SASU-Robotac/Robotac_Share/README.md

# Robotac_Share
Share docs and drawing for robotac
