SASU-Robotac/Robotac_Share/自动机器人/自动机器人基础版程序/ReadMe.txt

1、【Code_ForRobotac_ZDC_v2019_BaseType】 控制器基础程序。
2、控制器基础程序说明文档；
3、自动机器人控制器说明文档；
