SASU-Robotac/Robotac_Share/基础底盘/基础底盘开源机械图/基础车.SLDASM

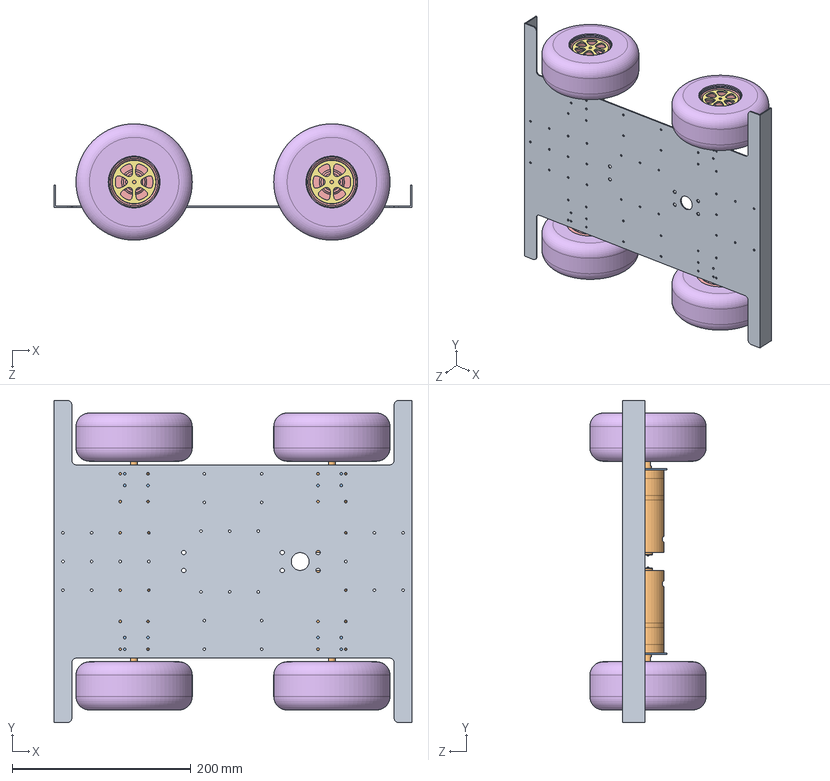
[picture p85: CAD file, 2020-01-18]
基础底盘/基础底盘开源机械图/基础车.SLDASM
400.2 x 360.0 x 129.9 mm
基础车钣金
电机YG36-555 x 4
电机座 x 4
六角联轴器 x 4
轮毂 x 4
胎皮 x 4
轮毂片 x 4
