SASU-Robotac/Robotac_Share/基础底盘/基础底盘开源机械图/轮系.SLDASM

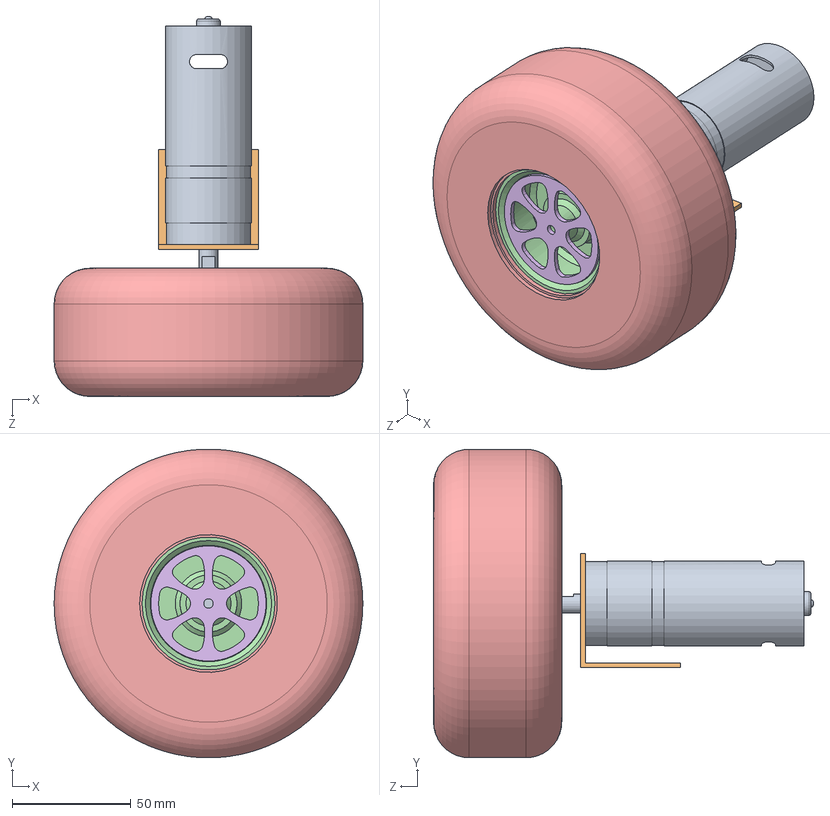
[picture p86: CAD file, 2020-01-18]
基础底盘/基础底盘开源机械图/轮系.SLDASM
130.0 x 129.9 x 160.0 mm
电机YG36-555
电机座
六角联轴器
轮毂
胎皮
轮毂片
