SASU-Robotac/Robotac_Share/气铲攻击机器人/气铲攻击机器人轮式配体/QC-气缸.SLDASM

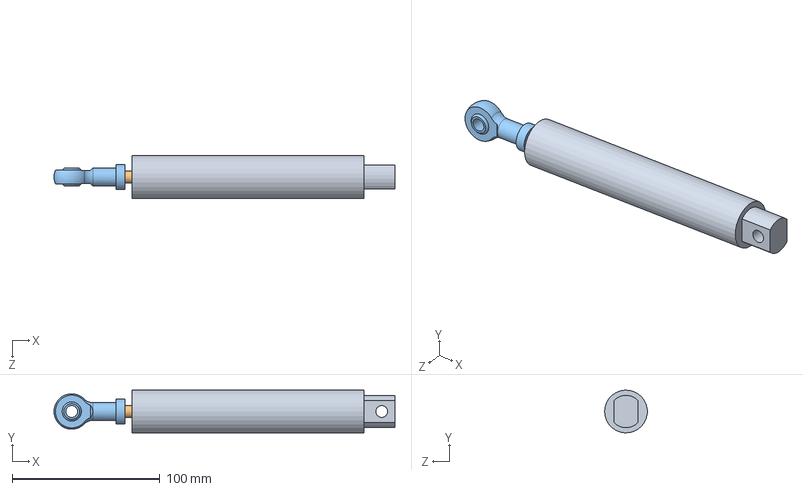
[picture p88: CAD file, 2020-02-25]
气铲攻击机器人/气铲攻击机器人轮式配体/QC-气缸.SLDASM
231.0 x 29.0 x 29.0 mm
QC-气缸壁
QC-气缸芯
QC-杆端轴承
