SASU-Robotac/Robotac_Share/气铲攻击机器人/气铲攻击机器人轮式配体/气铲总装配体.SLDASM

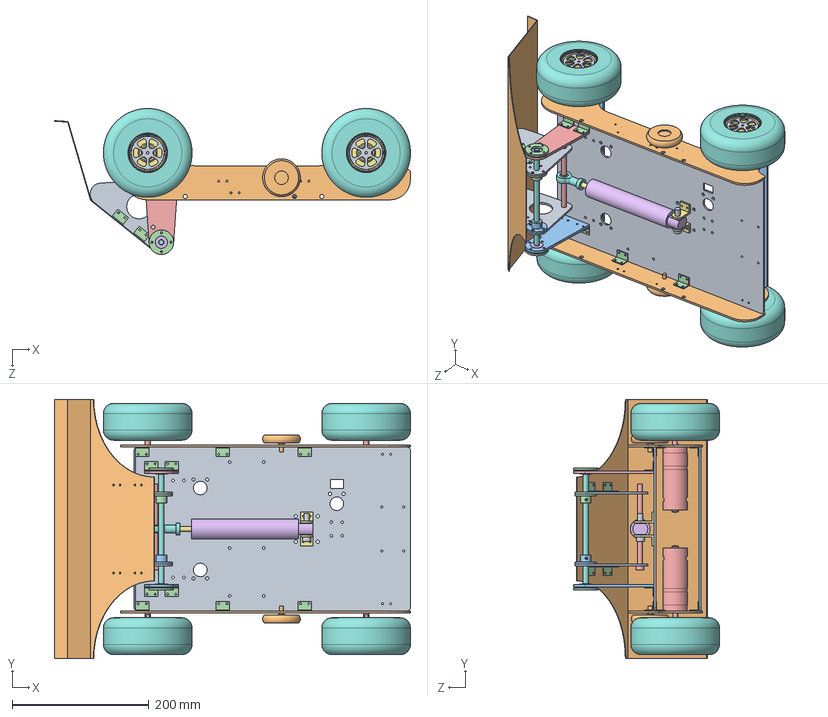
[picture p89: CAD file, 2020-02-25]
气铲攻击机器人/气铲攻击机器人轮式配体/气铲总装配体.SLDASM
521.6 x 380.0 x 214.0 mm
QC-底板
QC-侧板 x 2
QC-下板 x 2
直角连接件 x 20
电机YG36-555 x 4
六角联轴器 x 4
轮毂 x 4
胎皮 x 4
轮毂片 x 4
辅助轮 x 2
QC-轴支撑板
QC-轴承压片 x 2
M8x120螺栓
6mm轴承 x 2
直角支架 x 2
气铲横轴
QC-铲支撑板 x 2
铲
法兰联轴器-孔8
镜向法兰联轴器-孔8
镜向QC-轴支撑板
QC-气缸壁
QC-气缸芯
QC-杆端轴承
M8x35螺栓
