SASU-Robotac/Robotac_Share/电铲攻击机器人/电铲攻击机器人轮式装配体/电铲轮式装配体1.SLDASM

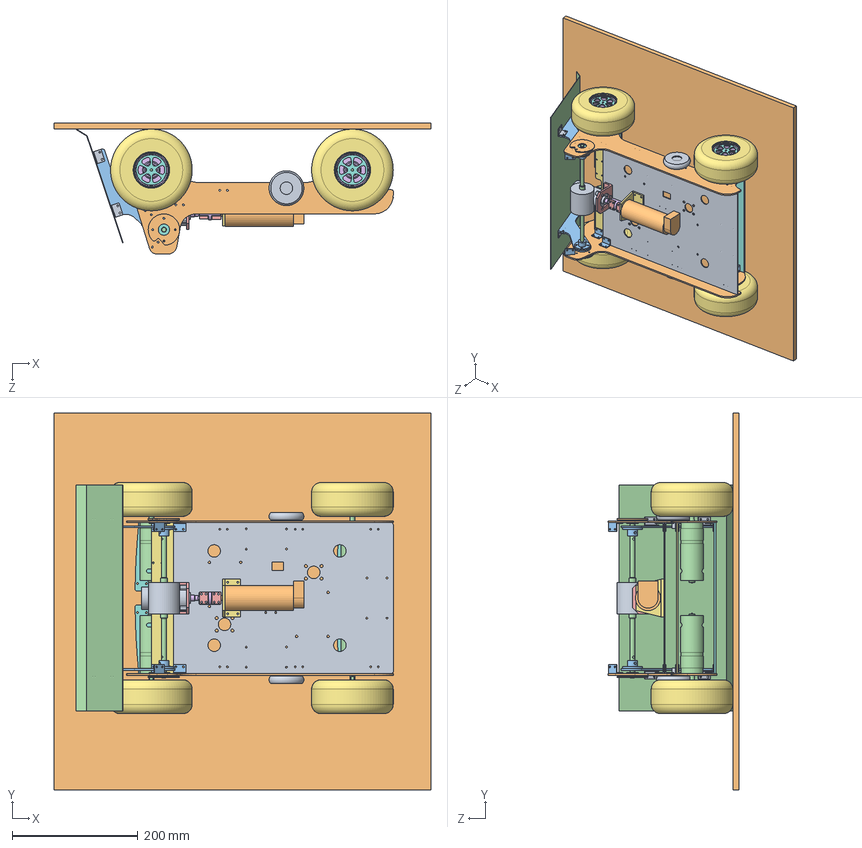
[picture p90: CAD file, 2020-02-17]
电铲攻击机器人/电铲攻击机器人轮式装配体/电铲轮式装配体1.SLDASM
600.0 x 600.0 x 209.0 mm
底板
侧板 x 2
直角连接件 x 18
电机YG36-555 x 4
六角联轴器 x 4
轮毂 x 4
胎皮 x 4
轮毂片 x 4
DC-换向器
DC-RE40
DC-法兰盘x2 x 2
DC-横轴x2 x 2
DC-换向器座
DC-纵轴
DC-电机座
DC-轴承 x 2
TY-直角连接件 x 4
轴承挡片 x 2
大臂 x 2
铲子
压片 x 2
压片联轴器
支撑板一
支撑板二 x 2
辅助轮 x 2
