SASU-Robotac/Robotac_Share/自动机器人/自动机器人装配体/轮系.SLDASM

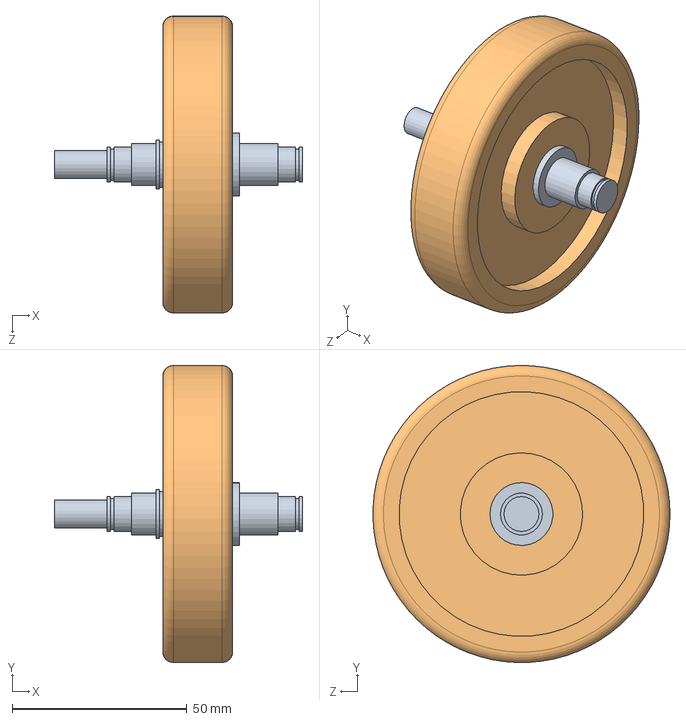
[picture p91: CAD file, 2020-03-14]
自动机器人/自动机器人装配体/轮系.SLDASM
71.0 x 85.0 x 85.0 mm
轮轴
轮子
