SASU-Robotac/Robotac_Share/电铲攻击机器人/电铲攻击机器人轮式装配体/轮系.SLDASM

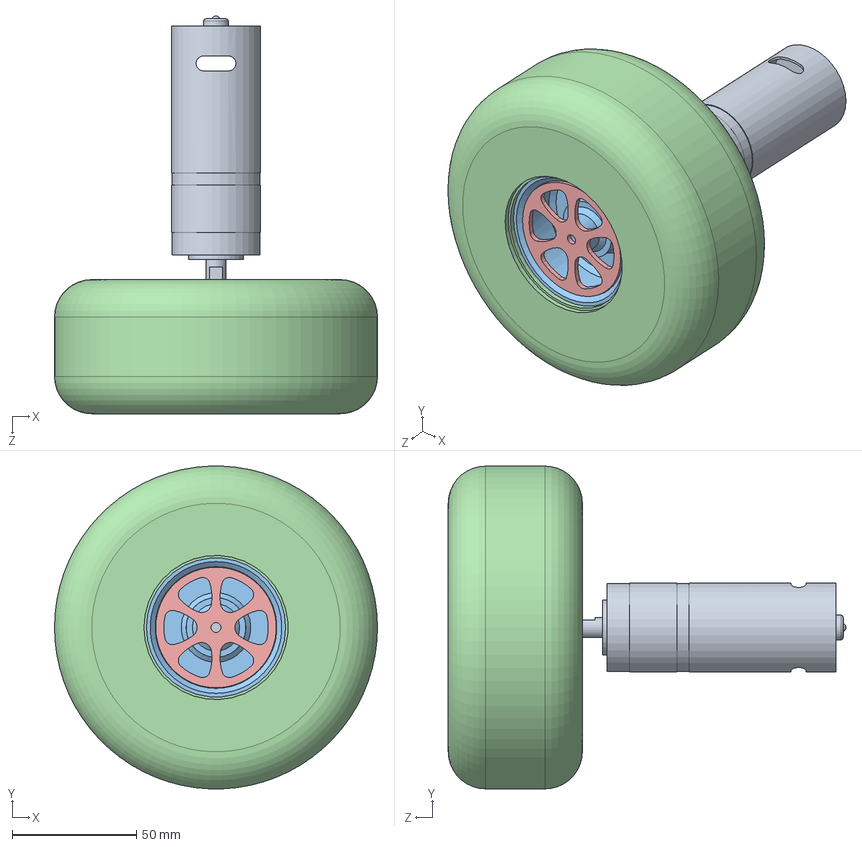
[picture p92: CAD file, 2020-02-17]
电铲攻击机器人/电铲攻击机器人轮式装配体/轮系.SLDASM
130.0 x 129.9 x 160.0 mm
电机YG36-555
六角联轴器
轮毂
胎皮
轮毂片
