SASU-Robotac/Robotac_Share/气铲攻击机器人/气铲攻击机器人轮式配体/气铲机构.SLDASM

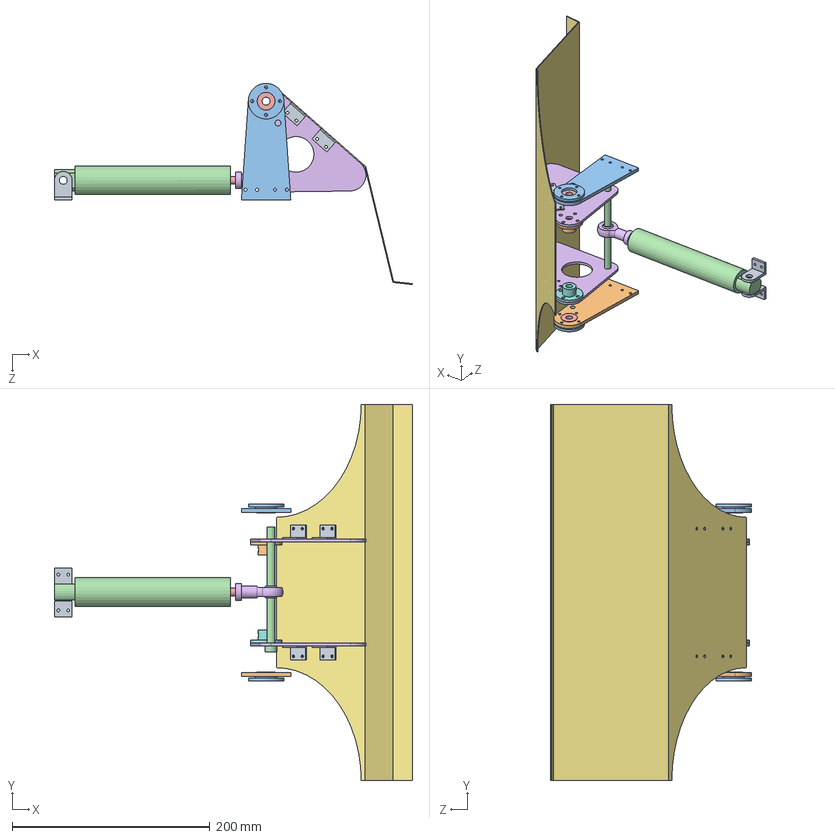
[picture p93: CAD file, 2020-02-25]
气铲攻击机器人/气铲攻击机器人轮式配体/气铲机构.SLDASM
362.0 x 380.0 x 203.4 mm
QC-轴支撑板
QC-轴承压片 x 2
M8x120螺栓
6mm轴承 x 2
直角支架 x 2
QC-铲支撑板 x 2
铲
法兰联轴器-孔8
直角连接件 x 4
镜向法兰联轴器-孔8
镜向QC-轴支撑板
QC-气缸壁
QC-气缸芯
QC-杆端轴承
