SASU-Robotac/Robotac_Share/电铲攻击机器人/电铲攻击机器人轮式装配体/DC-机构.SLDASM

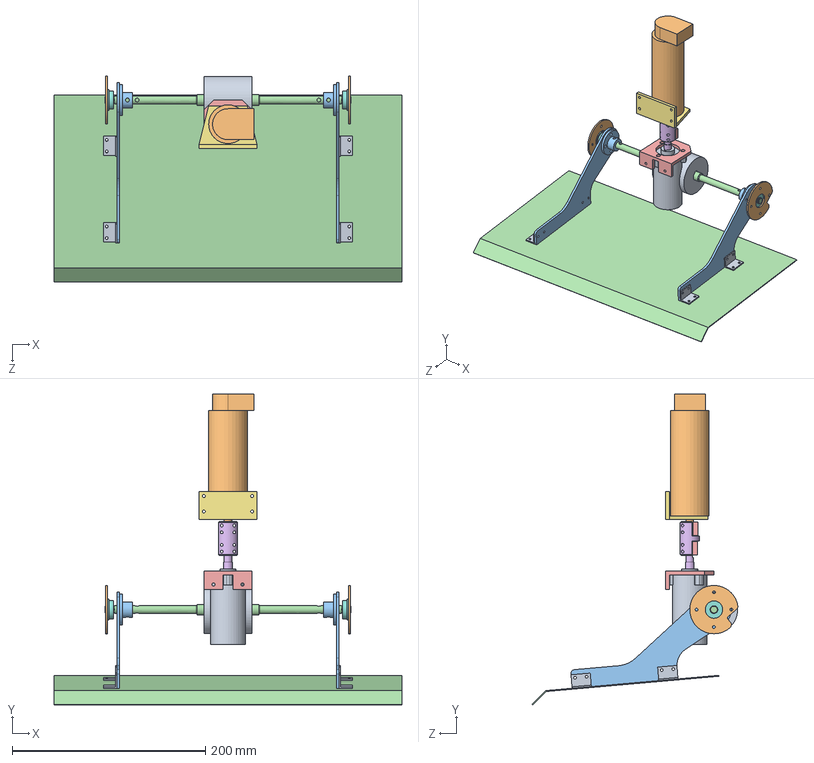
[picture p94: CAD file, 2020-02-17]
电铲攻击机器人/电铲攻击机器人轮式装配体/DC-机构.SLDASM
360.0 x 321.6 x 212.8 mm
DC-换向器
DC-RE40
DC-法兰盘x2 x 2
DC-横轴x2 x 2
DC-换向器座
DC-纵轴
DC-电机座
DC-轴承 x 2
TY-直角连接件 x 4
轴承挡片 x 2
大臂 x 2
铲子
压片 x 2
压片联轴器
