SASU-Robotac/Robotac_Share/自动机器人/自动机器人装配体/电机装配.SLDASM

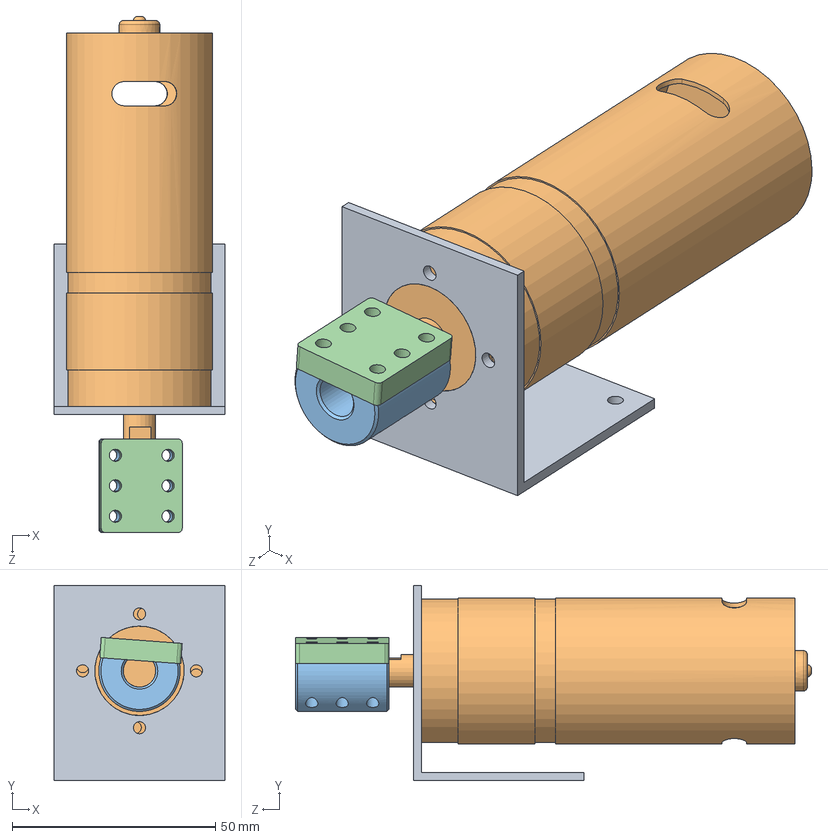
[picture p95: CAD file, 2020-03-14]
自动机器人/自动机器人装配体/电机装配.SLDASM
42.0 x 48.0 x 127.0 mm
电机座
电机YG36-555
压片联轴器
压片
