SASU-Robotac/Robotac_Share/自动机器人/自动机器人装配体/底盘装配体.SLDASM

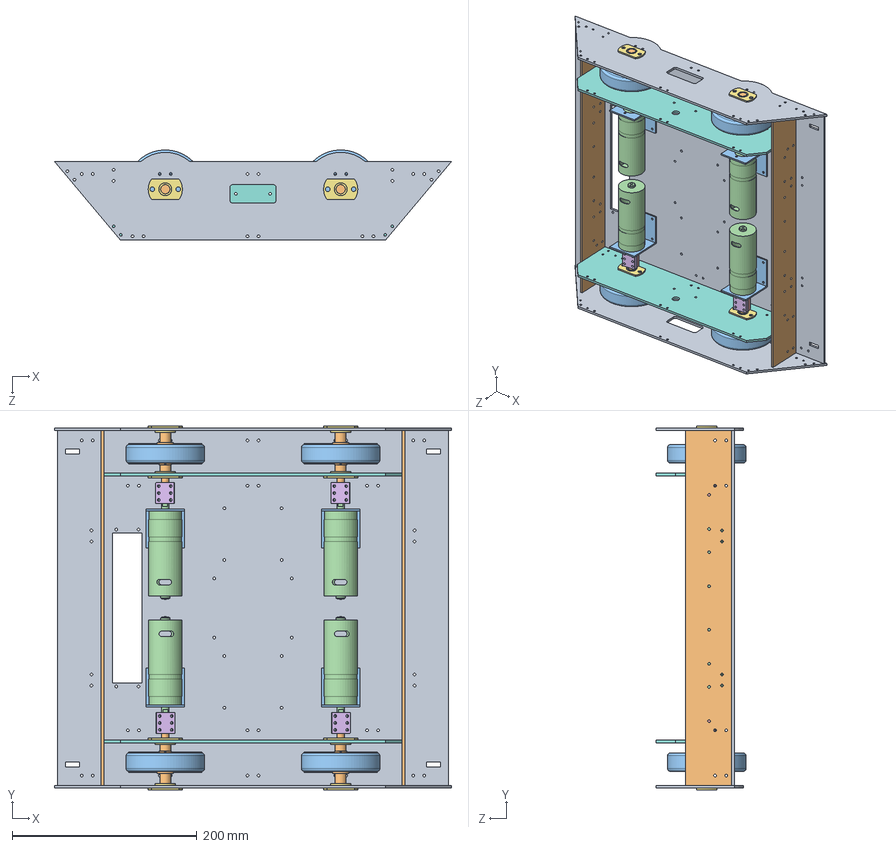
[picture p96: CAD file, 2020-03-14]
自动机器人/自动机器人装配体/底盘装配体.SLDASM
430.0 x 394.0 x 97.5 mm
侧面基板 x 2
红外安装板 x 2
电机座 x 4
电机YG36-555 x 4
压片联轴器 x 4
压片 x 4
轴承座 x 8
内侧轴承板 x 2
底盘基板
轮轴 x 4
轮子 x 4
