SASU-Robotac/Robotac_Share/气铲攻击机器人/气铲攻击机器人轮式配体/QC-杆端轴承.SLDPRT

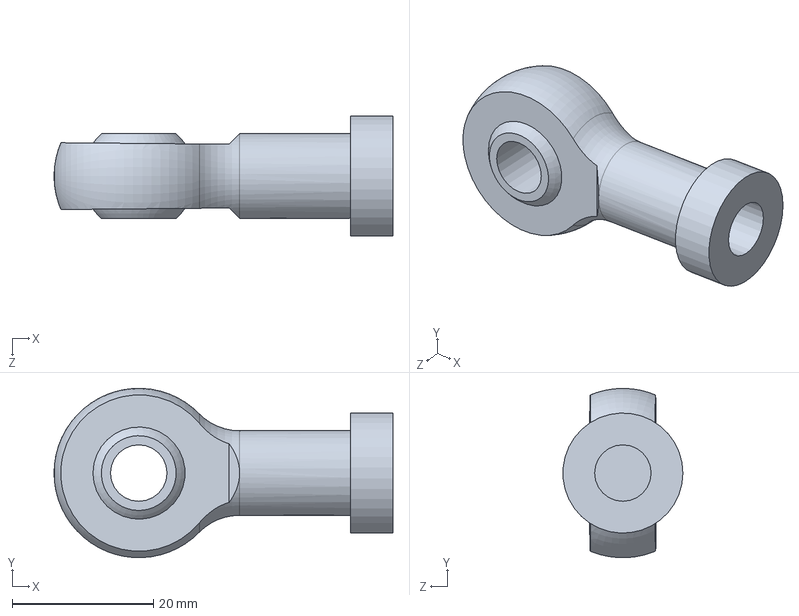
[picture p97: CAD file, 2020-02-25]
气铲攻击机器人/气铲攻击机器人轮式配体/QC-杆端轴承.SLDPRT
48.0 x 24.0 x 17.0 mm
