SASU-Robotac/Robotac_Share/电铲攻击机器人/电铲攻击机器人轮式装配体/支撑板一.SLDPRT

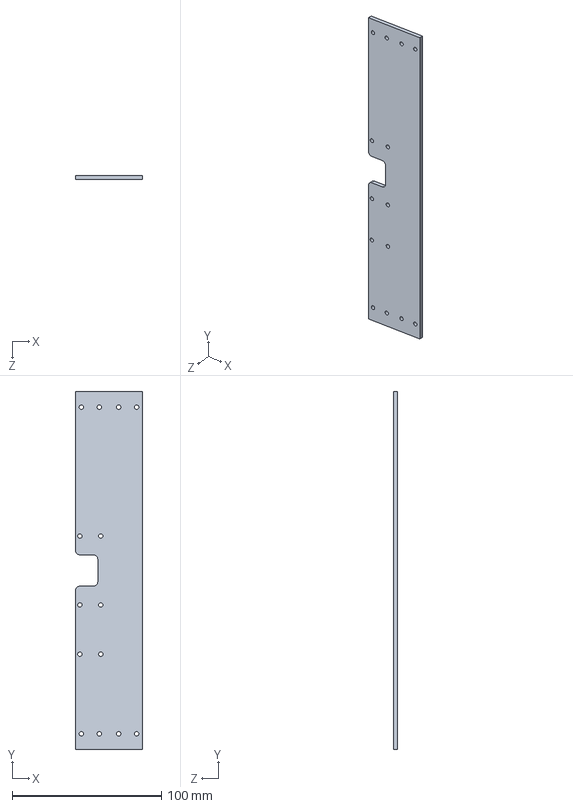
[picture p98: CAD file, 2020-02-17]
电铲攻击机器人/电铲攻击机器人轮式装配体/支撑板一.SLDPRT
45.0 x 240.0 x 3.00 mm
