SASU-Robotac/Robotac_Share/自动机器人/自动机器人装配体/轴承座.SLDPRT

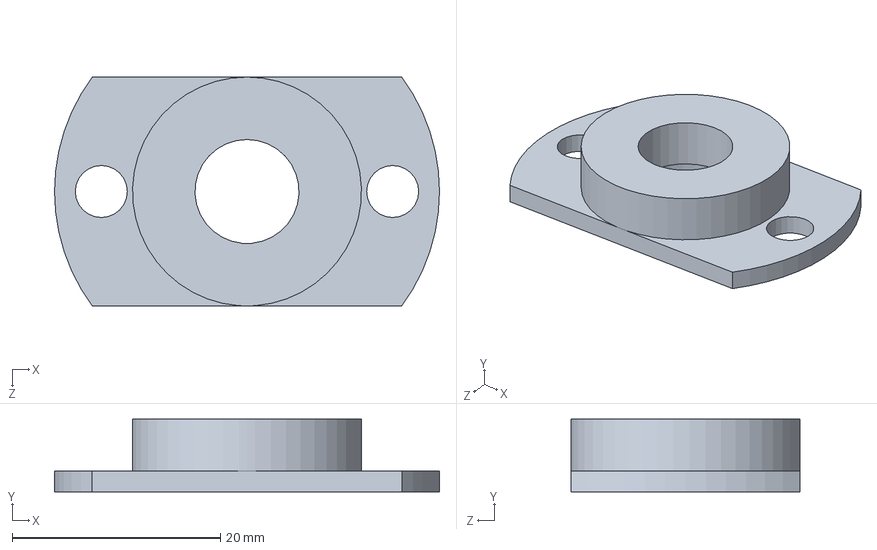
[picture p99: CAD file, 2020-03-14]
自动机器人/自动机器人装配体/轴承座.SLDPRT
37.0 x 7.00 x 22.0 mm
