SASU-Robotac/Robotac_Share/基础底盘/基础底盘开源机械图/电机座.SLDPRT

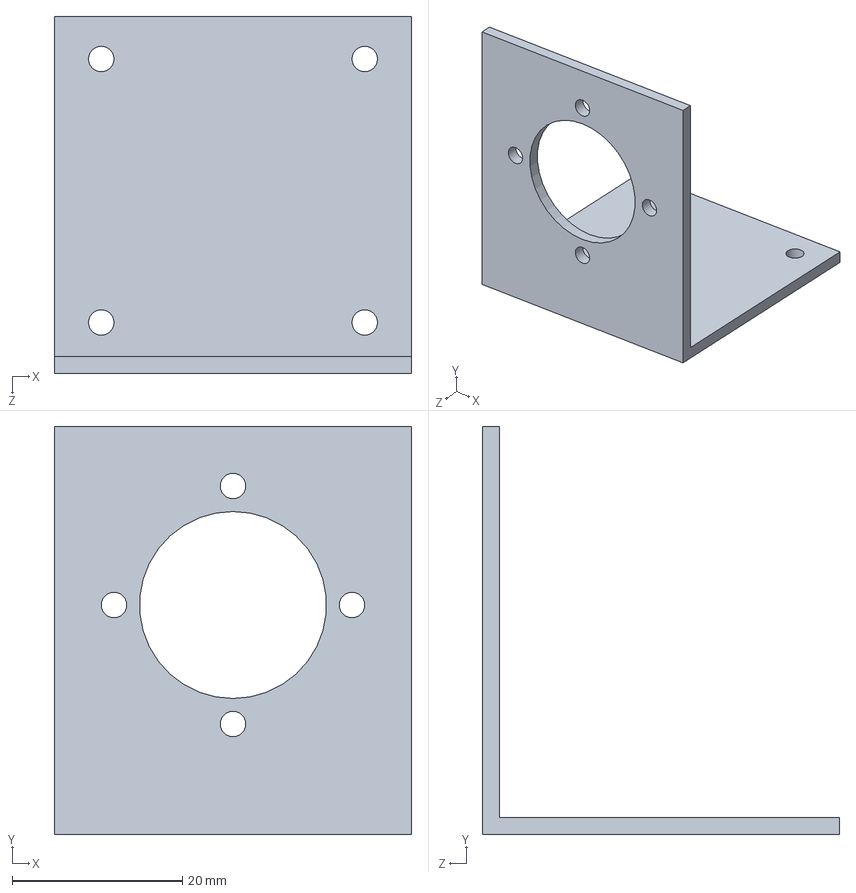
[picture p100: CAD file, 2020-01-18]
基础底盘/基础底盘开源机械图/电机座.SLDPRT
42.0 x 48.0 x 42.0 mm
