SASU-Robotac/Robotac_Share/气铲攻击机器人/气铲攻击机器人轮式配体/6mm轴承.SLDPRT

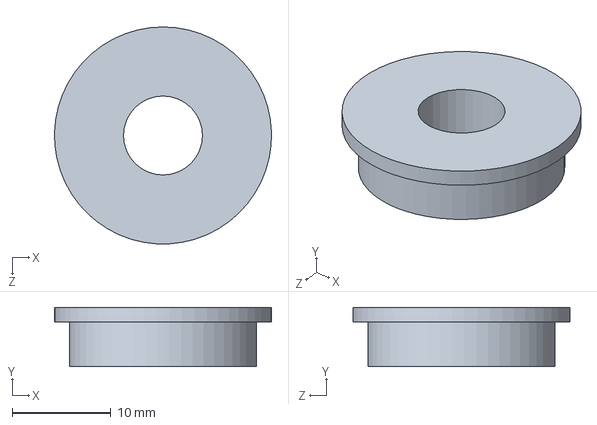
[picture p101: CAD file, 2020-02-25]
气铲攻击机器人/气铲攻击机器人轮式配体/6mm轴承.SLDPRT
22.0 x 6.00 x 22.0 mm
