SASU-Robotac/Robotac_Share/电铲攻击机器人/电铲攻击机器人轮式装配体/压片.SLDPRT

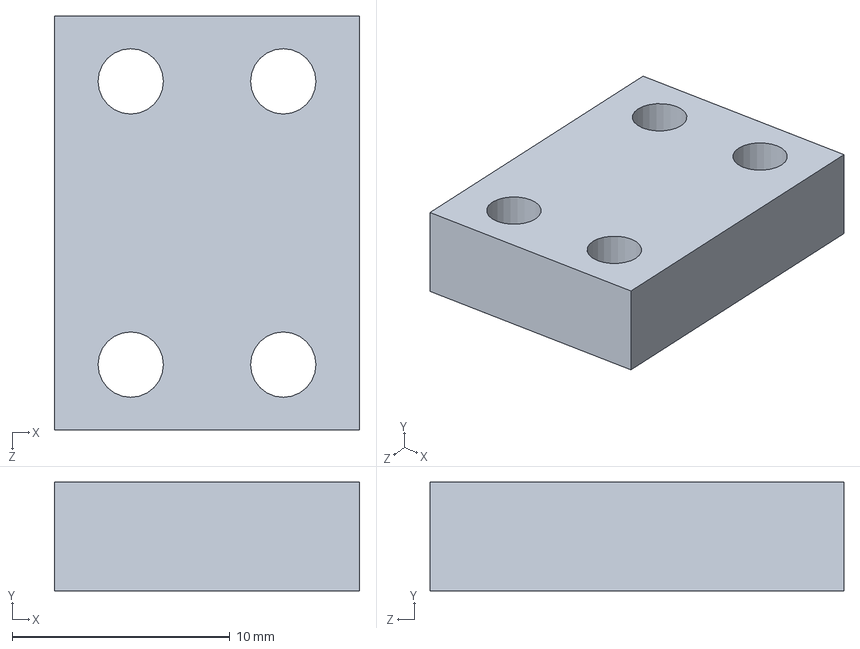
[picture p102: CAD file, 2020-02-17]
电铲攻击机器人/电铲攻击机器人轮式装配体/压片.SLDPRT
14.0 x 5.00 x 19.0 mm
