SASU-Robotac/Robotac_Share/自动机器人/自动机器人装配体/内侧轴承板.SLDPRT

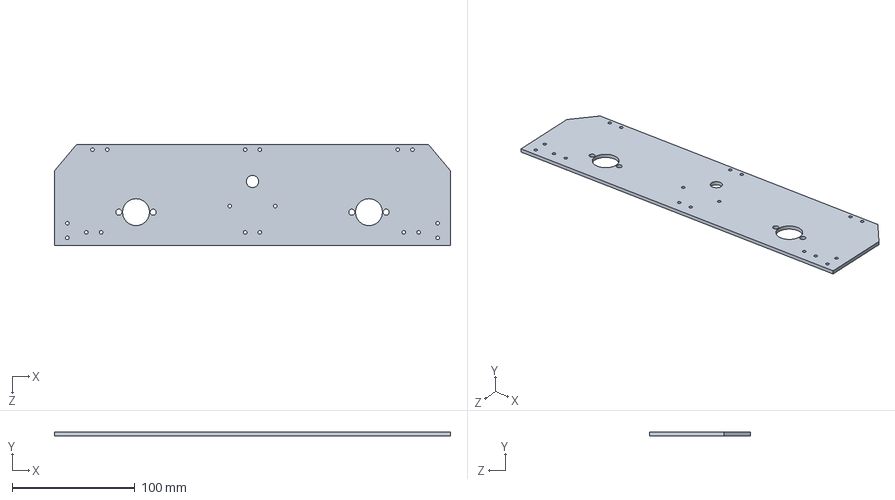
[picture p103: CAD file, 2020-03-14]
自动机器人/自动机器人装配体/内侧轴承板.SLDPRT
323.0 x 3.00 x 82.0 mm
