SASU-Robotac/Robotac_Share/气铲攻击机器人/气铲攻击机器人轮式配体/QC-底板.SLDPRT

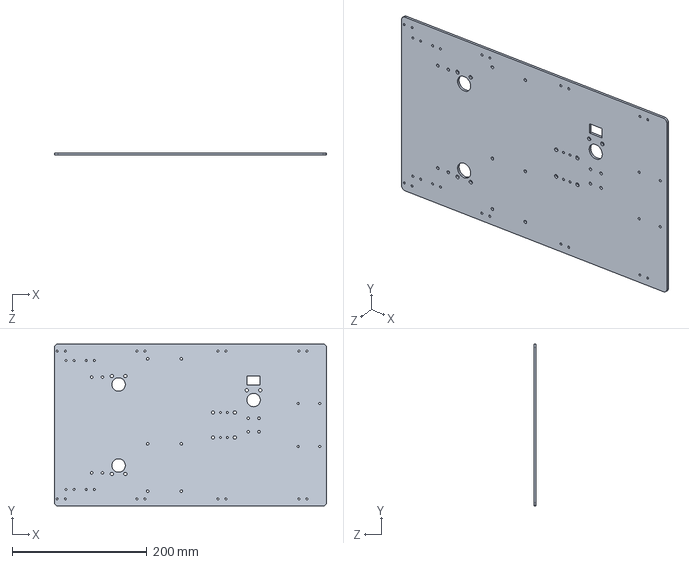
[picture p104: CAD file, 2020-02-25]
气铲攻击机器人/气铲攻击机器人轮式配体/QC-底板.SLDPRT
403.0 x 240.0 x 3.00 mm
