SASU-Robotac/Robotac_Share/电铲攻击机器人/电铲攻击机器人轮式装配体/大臂.SLDPRT

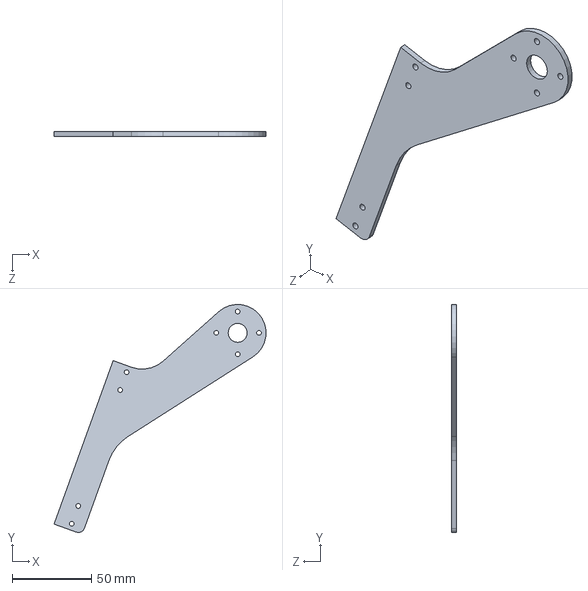
[picture p105: CAD file, 2020-02-17]
电铲攻击机器人/电铲攻击机器人轮式装配体/大臂.SLDPRT
134.1 x 144.3 x 3.00 mm
