SASU-Robotac/Robotac_Share/自动机器人/自动机器人装配体/红外安装板.SLDPRT

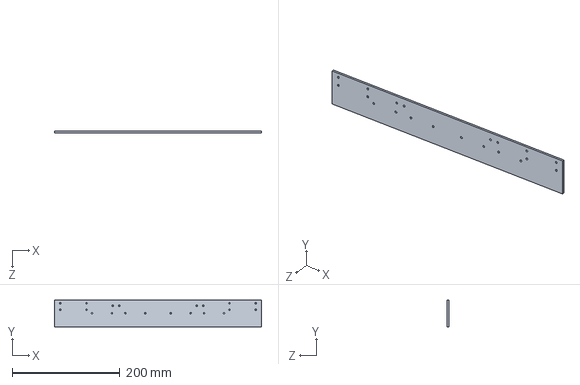
[picture p106: CAD file, 2020-03-14]
自动机器人/自动机器人装配体/红外安装板.SLDPRT
384.0 x 50.0 x 3.00 mm
