SASU-Robotac/Robotac_Share/基础底盘/基础底盘开源机械图/电机YG36-555.SLDPRT

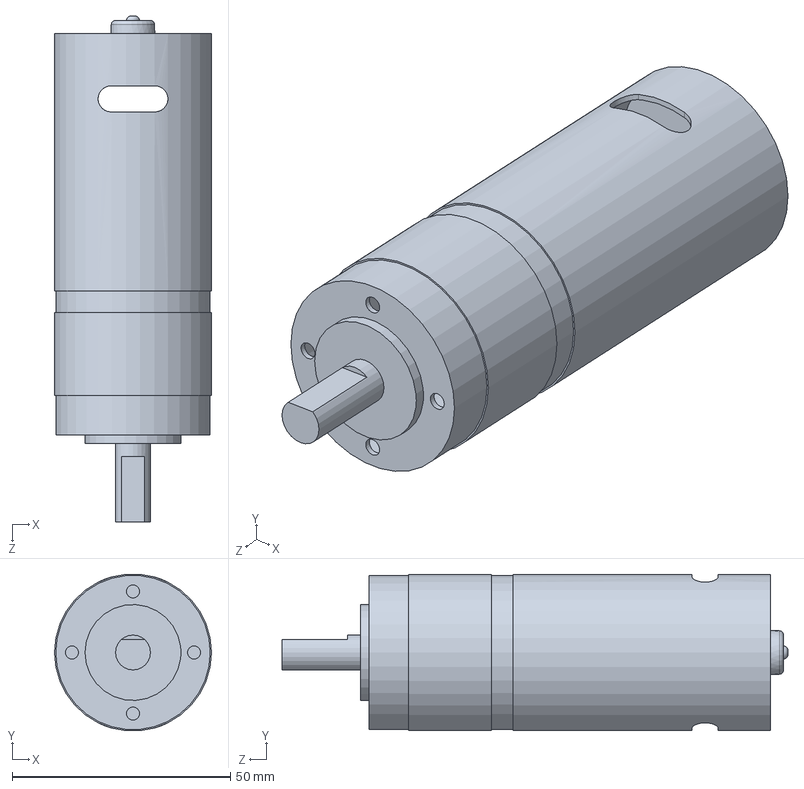
[picture p107: CAD file, 2020-01-18]
基础底盘/基础底盘开源机械图/电机YG36-555.SLDPRT
36.0 x 35.8 x 116.0 mm
