SASU-Robotac/Robotac_Share/气铲攻击机器人/气铲攻击机器人轮式配体/QC-气缸头.SLDPRT

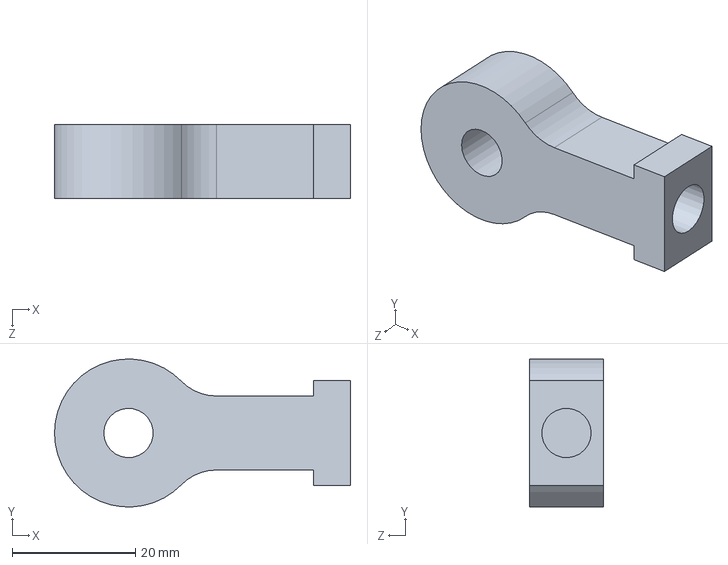
[picture p108: CAD file, 2020-02-25]
气铲攻击机器人/气铲攻击机器人轮式配体/QC-气缸头.SLDPRT
48.0 x 24.0 x 12.0 mm
