SASU-Robotac/Robotac_Share/自动机器人/自动机器人装配体/轮轴.SLDPRT

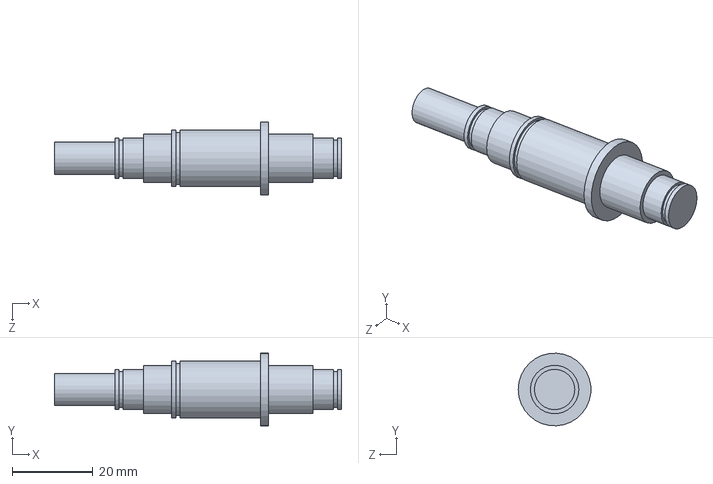
[picture p110: CAD file, 2020-03-14]
自动机器人/自动机器人装配体/轮轴.SLDPRT
71.0 x 18.0 x 18.0 mm
