SASU-Robotac/Robotac_Share/基础底盘/基础底盘开源机械图/基础车钣金.SLDPRT

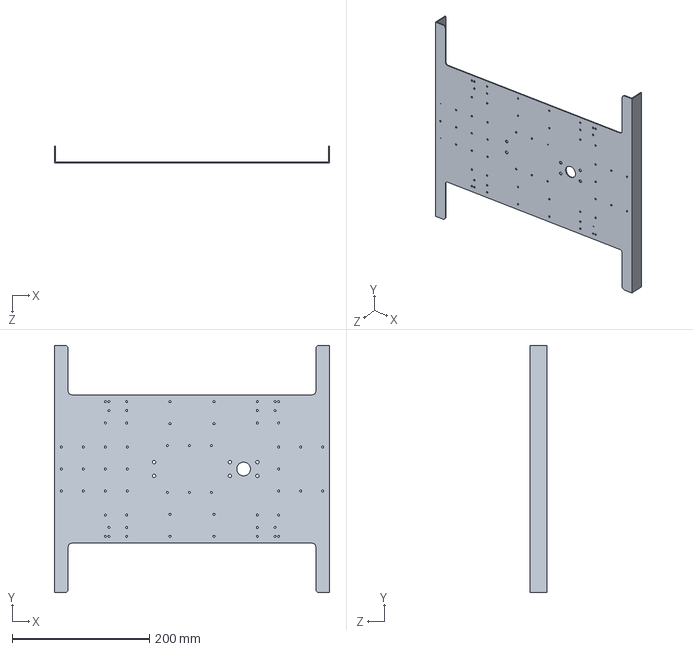
[picture p111: CAD file, 2020-01-18]
基础底盘/基础底盘开源机械图/基础车钣金.SLDPRT
400.2 x 360.0 x 25.0 mm
