SASU-Robotac/Robotac_Share/气铲攻击机器人/气铲攻击机器人轮式配体/QC-铲支撑板.SLDPRT

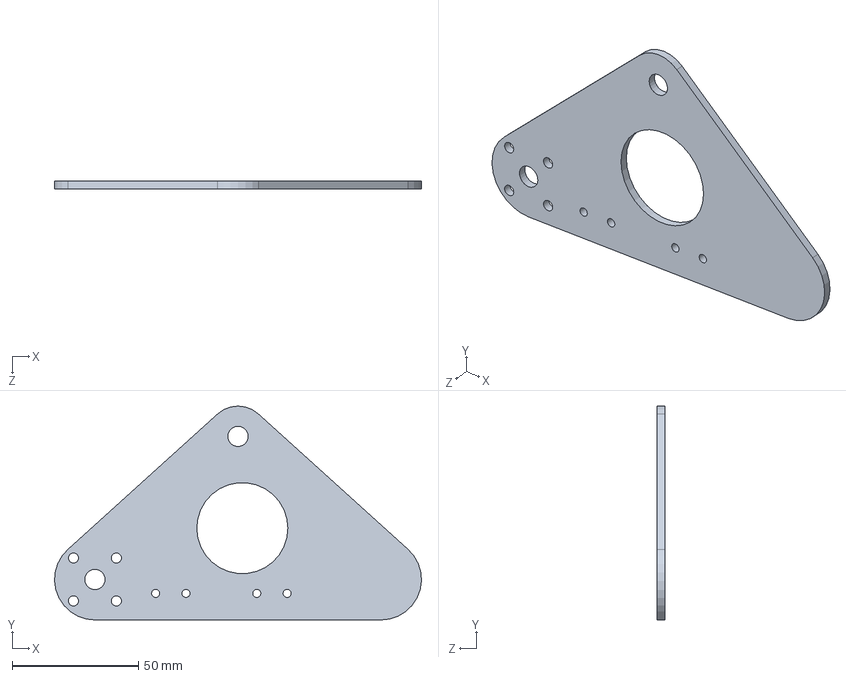
[picture p112: CAD file, 2020-02-25]
气铲攻击机器人/气铲攻击机器人轮式配体/QC-铲支撑板.SLDPRT
145.1 x 84.6 x 3.00 mm
