SASU-Robotac/Robotac_Share/自动机器人/自动机器人装配体/直角连接件.SLDPRT

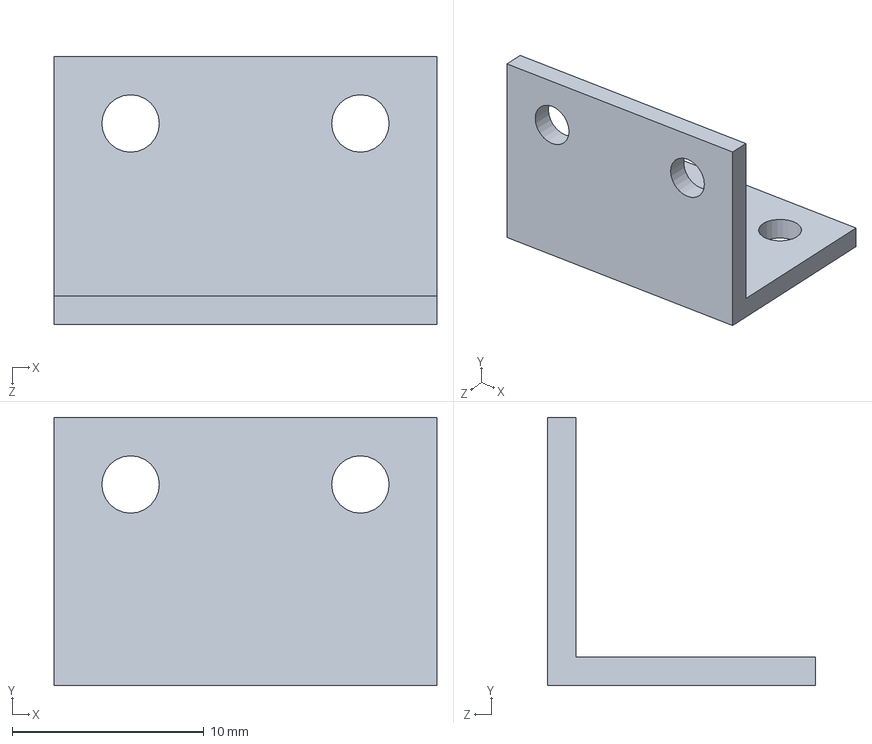
[picture p113: CAD file, 2020-03-14]
自动机器人/自动机器人装配体/直角连接件.SLDPRT
20.0 x 14.0 x 14.0 mm
