SASU-Robotac/Robotac_Share/电铲攻击机器人/电铲攻击机器人轮式装配体/DC-纵轴.SLDPRT

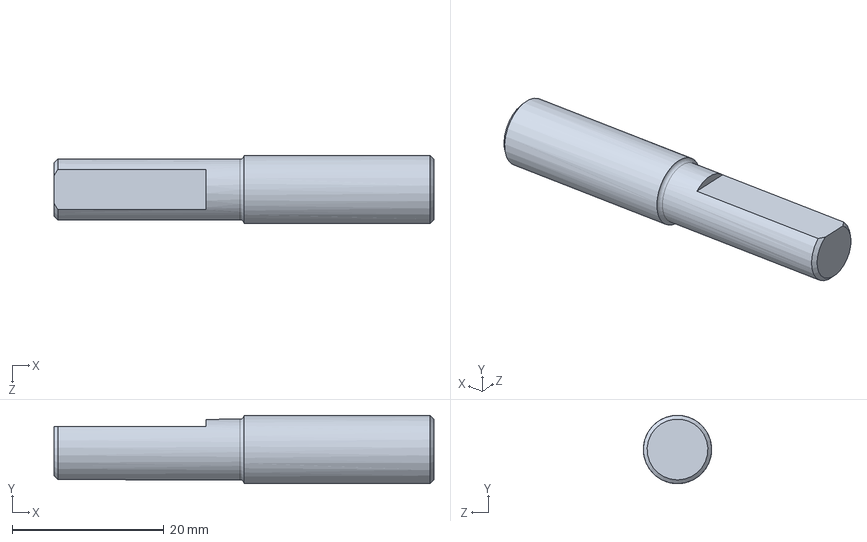
[picture p114: CAD file, 2020-02-17]
电铲攻击机器人/电铲攻击机器人轮式装配体/DC-纵轴.SLDPRT
50.0 x 9.00 x 8.98 mm
