SASU-Robotac/Robotac_Share/气铲攻击机器人/气铲攻击机器人轮式配体/QC-轴承压片.SLDPRT

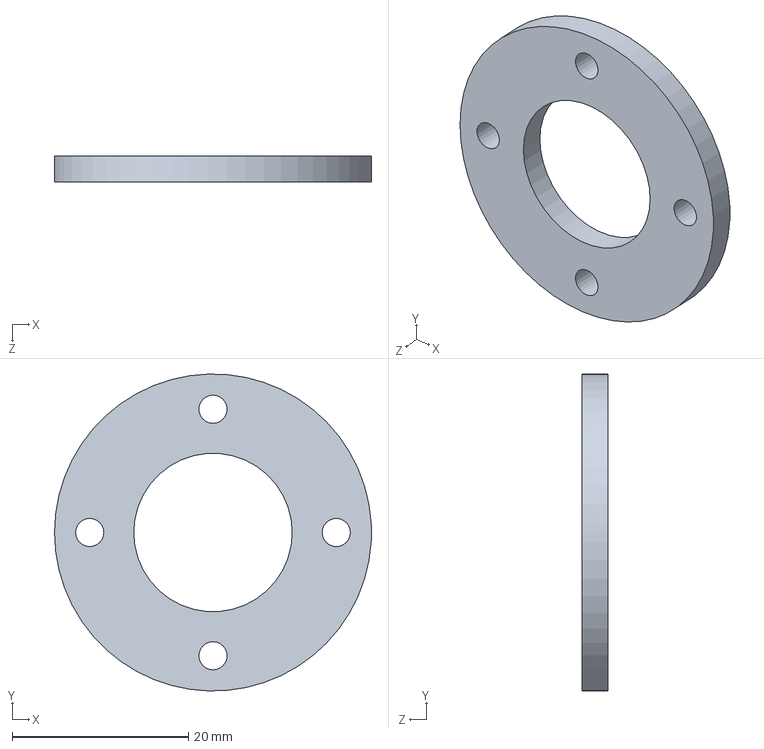
[picture p115: CAD file, 2020-02-25]
气铲攻击机器人/气铲攻击机器人轮式配体/QC-轴承压片.SLDPRT
36.0 x 36.0 x 3.00 mm
