SASU-Robotac/Robotac_Share/电铲攻击机器人/电铲攻击机器人轮式装配体/DC-RE40.SLDPRT

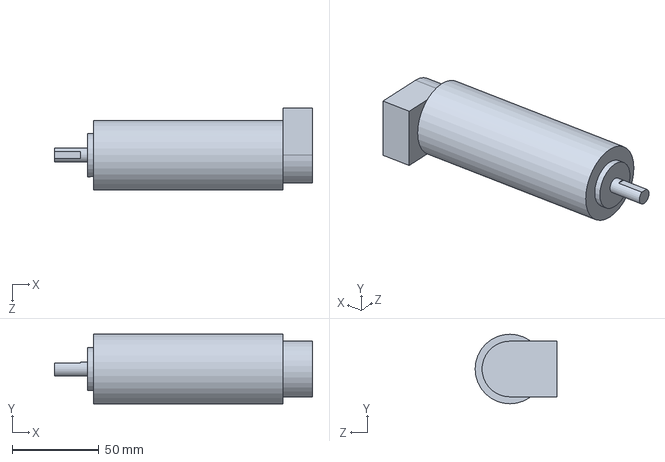
[picture p116: CAD file, 2020-02-17]
电铲攻击机器人/电铲攻击机器人轮式装配体/DC-RE40.SLDPRT
148.3 x 40.0 x 47.0 mm
