SASU-Robotac/Robotac_Share/自动机器人/自动机器人装配体/电机YG36-555.SLDPRT

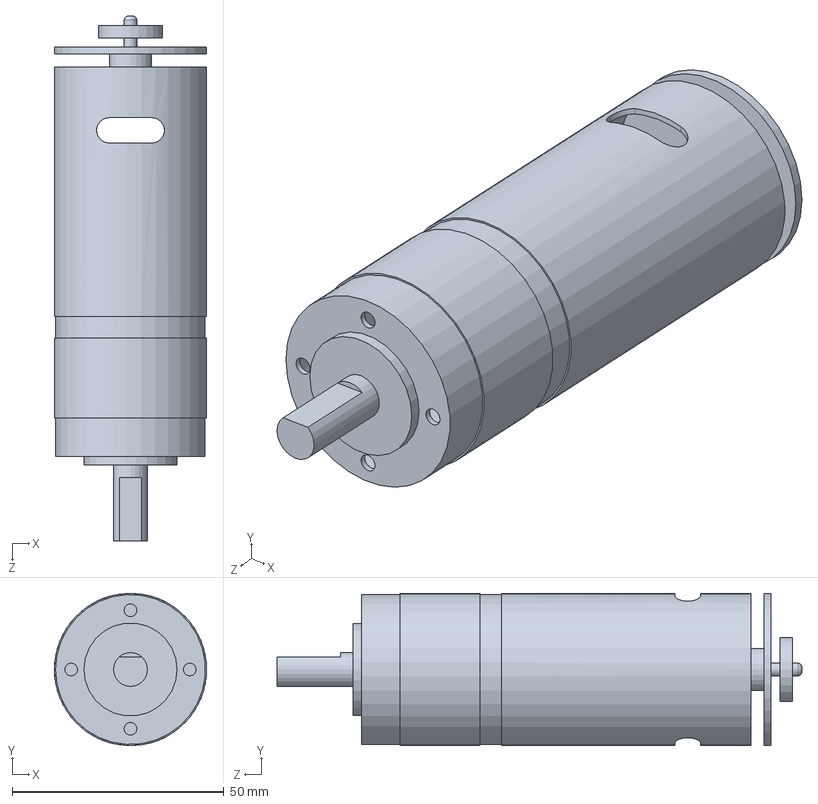
[picture p117: CAD file, 2020-03-14]
自动机器人/自动机器人装配体/电机YG36-555.SLDPRT
36.0 x 36.0 x 124.0 mm
