SASU-Robotac/Robotac_Share/电铲攻击机器人/电铲攻击机器人轮式装配体/DC-电机座.SLDPRT

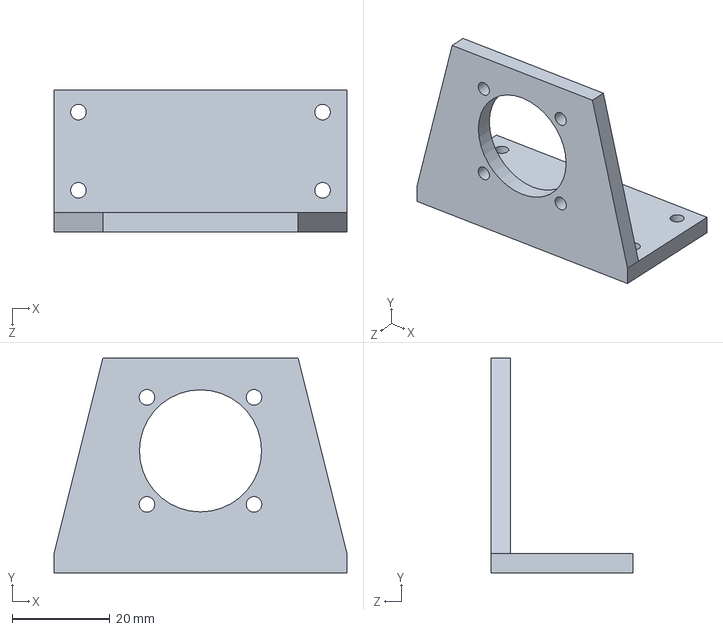
[picture p118: CAD file, 2020-02-17]
电铲攻击机器人/电铲攻击机器人轮式装配体/DC-电机座.SLDPRT
60.0 x 44.0 x 29.0 mm
