SASU-Robotac/Robotac_Share/自动机器人/自动机器人装配体/轮子.SLDPRT

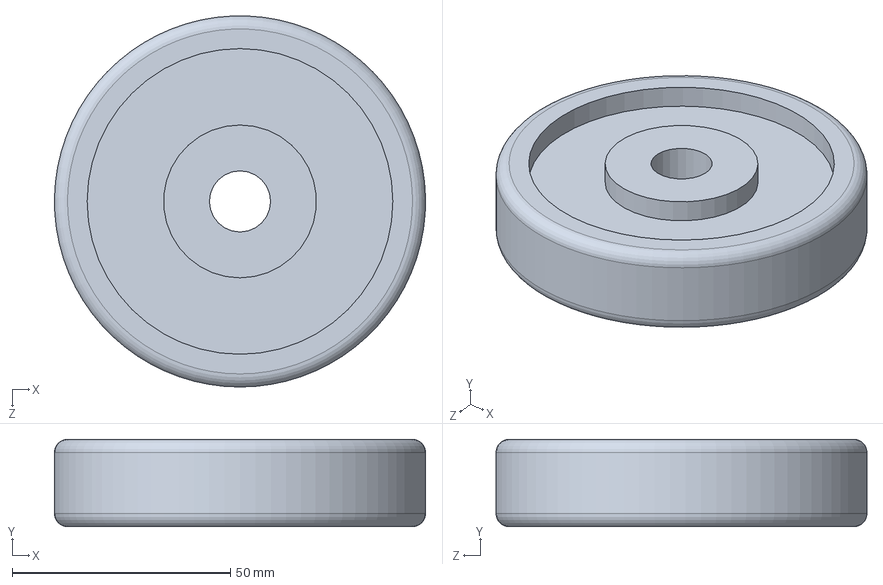
[picture p119: CAD file, 2020-03-14]
自动机器人/自动机器人装配体/轮子.SLDPRT
85.0 x 20.0 x 85.0 mm
