SASU-Robotac/Robotac_Share/气铲攻击机器人/气铲攻击机器人轮式配体/QC-气缸壁.SLDPRT

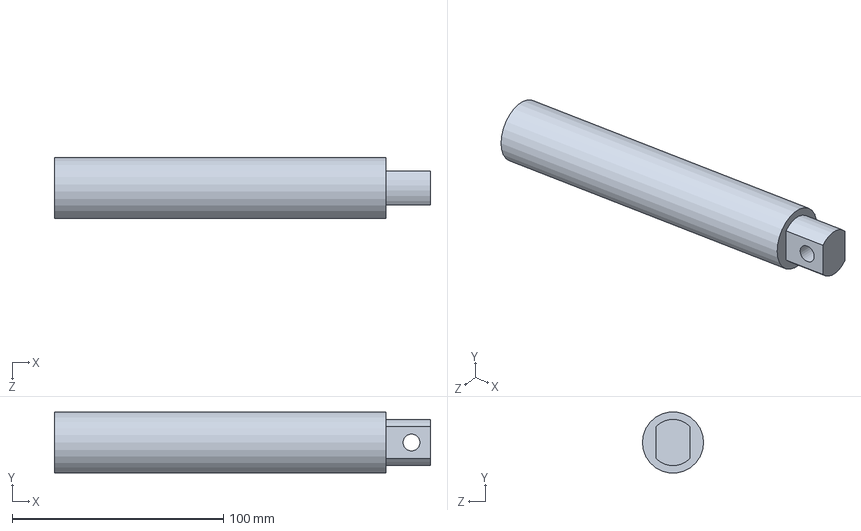
[picture p120: CAD file, 2020-02-25]
气铲攻击机器人/气铲攻击机器人轮式配体/QC-气缸壁.SLDPRT
178.0 x 28.8 x 29.0 mm
