SASU-Robotac/Robotac_Share/自动机器人/自动机器人装配体/盖板固定块.SLDPRT

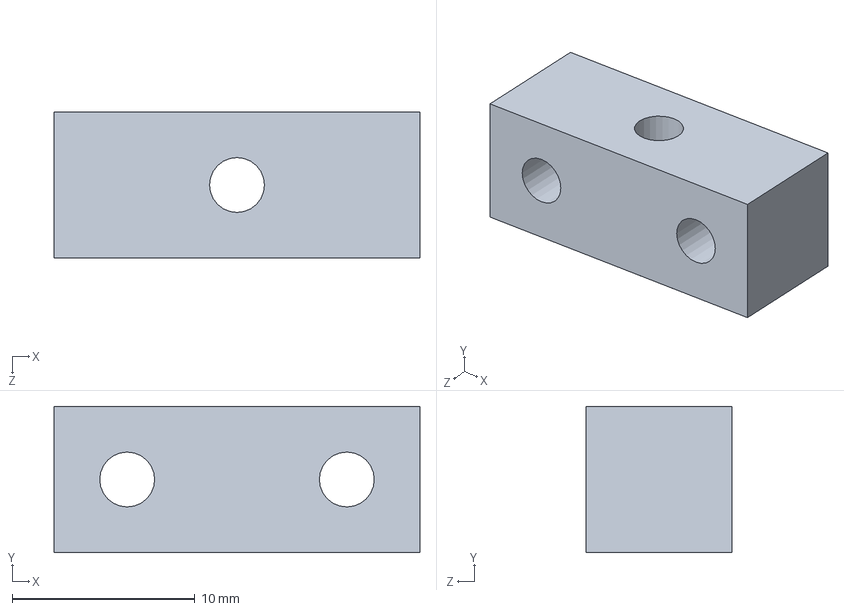
[picture p121: CAD file, 2020-03-14]
自动机器人/自动机器人装配体/盖板固定块.SLDPRT
20.0 x 8.00 x 8.00 mm
