SASU-Robotac/Robotac_Share/自动机器人/自动机器人装配体/侧面基板.SLDPRT

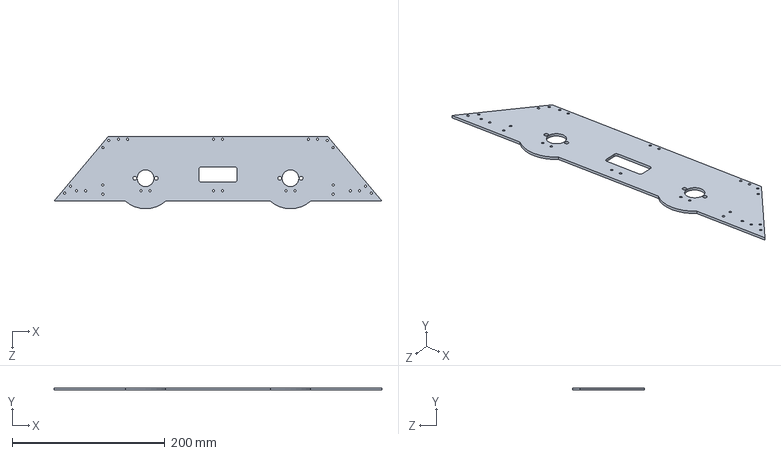
[picture p122: CAD file, 2020-03-14]
自动机器人/自动机器人装配体/侧面基板.SLDPRT
430.0 x 3.00 x 95.0 mm
