SASU-Robotac/Robotac_Share/气铲攻击机器人/气铲攻击机器人轮式配体/直角支架.SLDPRT

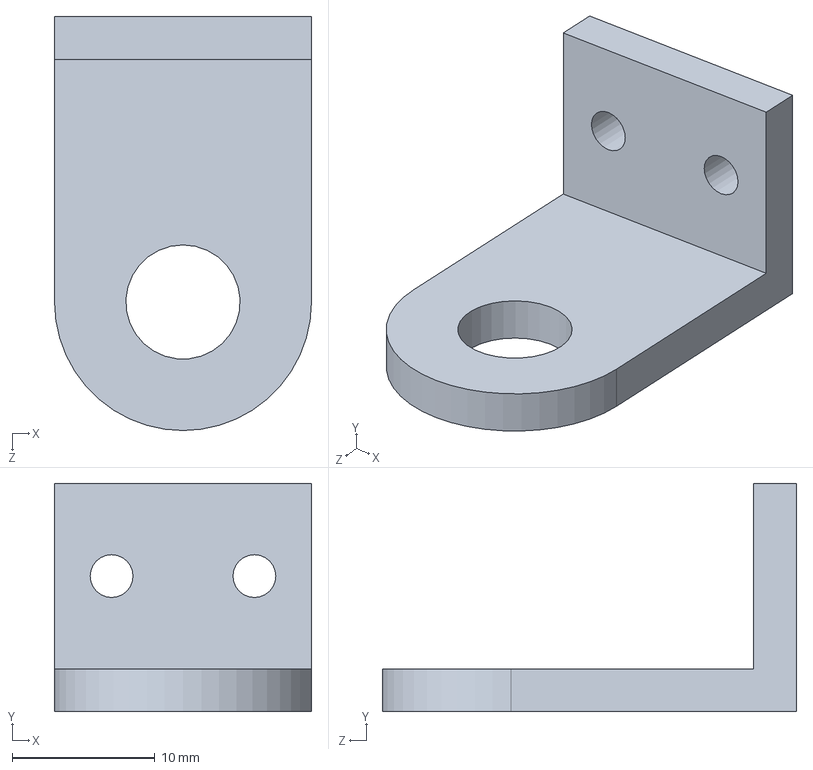
[picture p123: CAD file, 2020-02-25]
气铲攻击机器人/气铲攻击机器人轮式配体/直角支架.SLDPRT
18.0 x 16.0 x 29.0 mm
