SASU-Robotac/Robotac_Share/电铲攻击机器人/电铲攻击机器人轮式装配体/侧板.SLDPRT

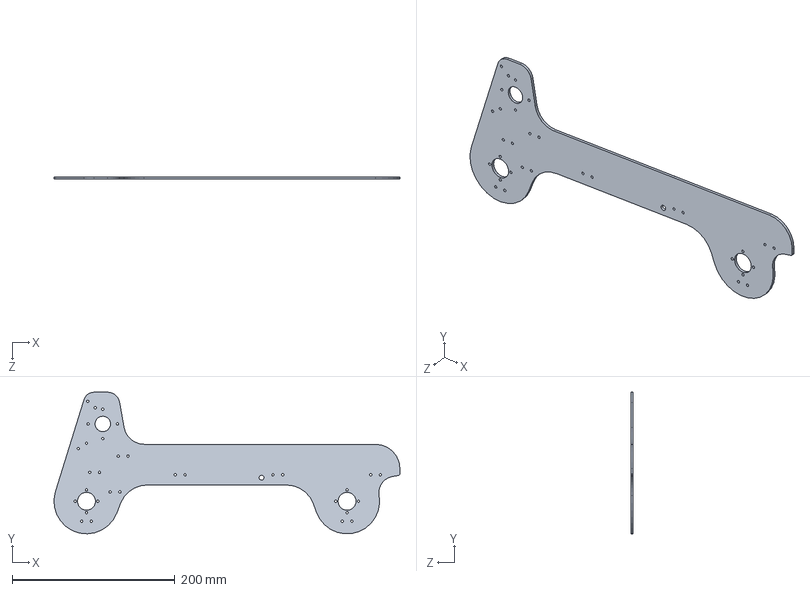
[picture p124: CAD file, 2020-02-17]
电铲攻击机器人/电铲攻击机器人轮式装配体/侧板.SLDPRT
424.9 x 174.0 x 3.00 mm
