SASU-Robotac/Robotac_Share/自动机器人/自动机器人装配体/铲子2.SLDPRT

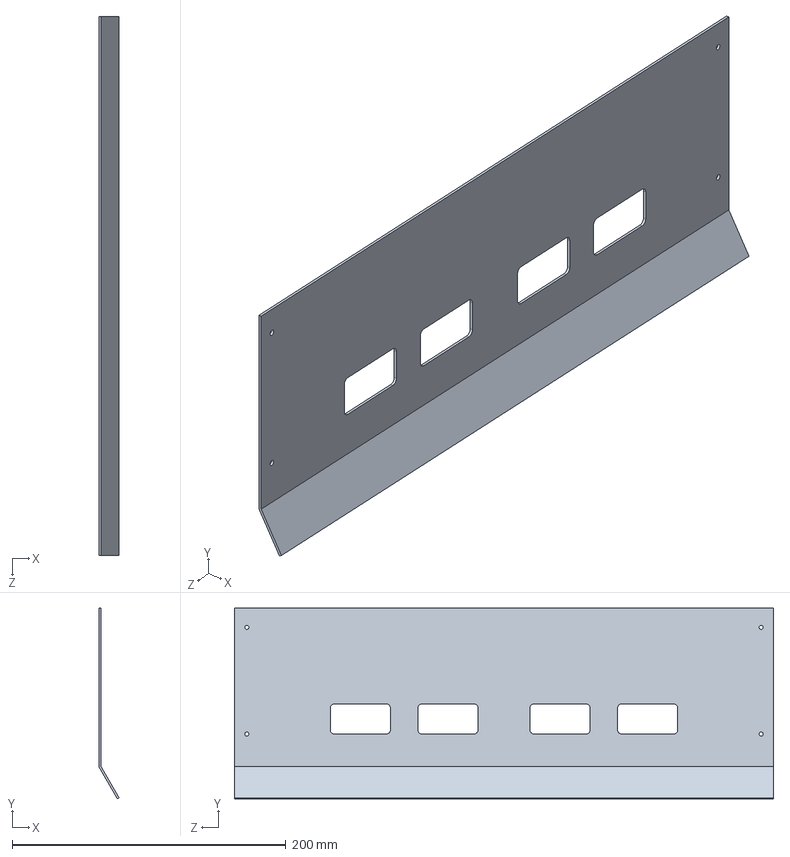
[picture p125: CAD file, 2020-03-14]
自动机器人/自动机器人装配体/铲子2.SLDPRT
14.8 x 139.4 x 394.0 mm
