SASU-Robotac/Robotac_Share/气铲攻击机器人/气铲攻击机器人轮式配体/QC-下板.SLDPRT

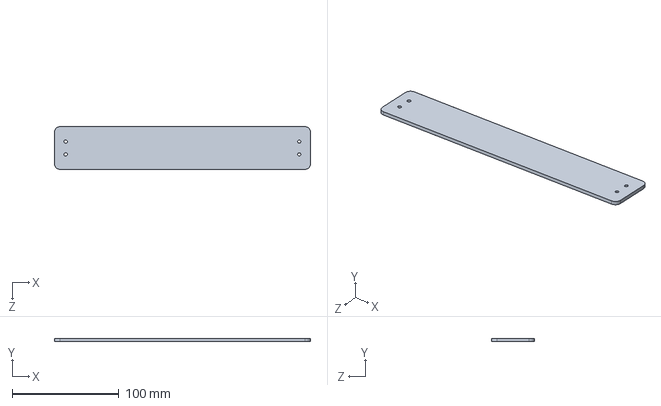
[picture p126: CAD file, 2020-02-25]
气铲攻击机器人/气铲攻击机器人轮式配体/QC-下板.SLDPRT
240.0 x 3.00 x 40.0 mm
