SASU-Robotac/Robotac_Share/电铲攻击机器人/电铲攻击机器人轮式装配体/压片联轴器.SLDPRT

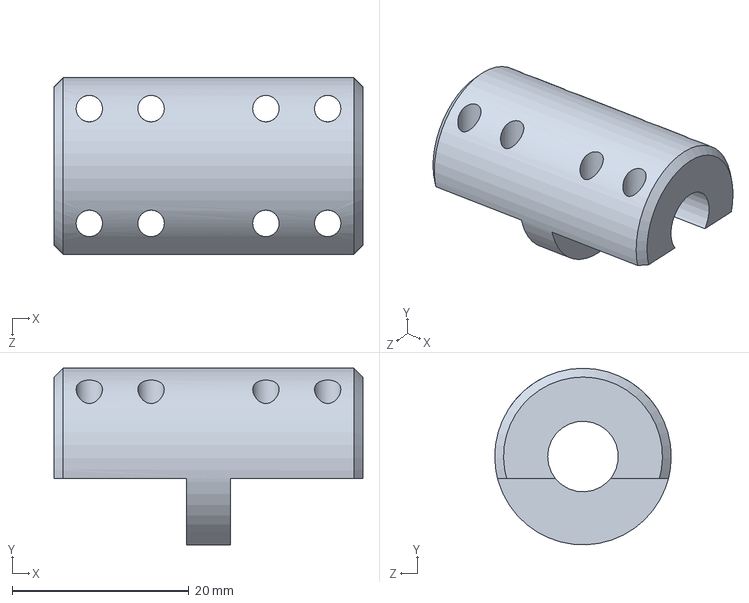
[picture p127: CAD file, 2020-02-17]
电铲攻击机器人/电铲攻击机器人轮式装配体/压片联轴器.SLDPRT
35.0 x 20.0 x 20.0 mm
