SASU-Robotac/Robotac_Share/自动机器人/自动机器人装配体/4红外测距.SLDPRT

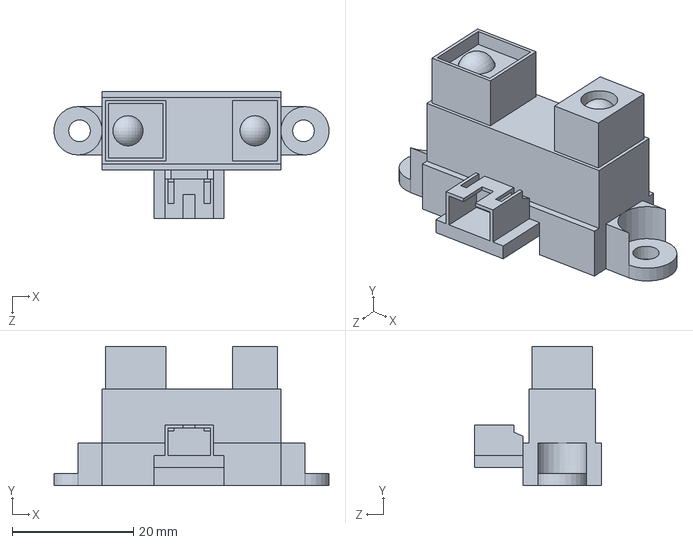
[picture p128: CAD file, 2020-03-14]
自动机器人/自动机器人装配体/4红外测距.SLDPRT
45.4 x 23.0 x 21.0 mm
