SASU-Robotac/Robotac_Share/气铲攻击机器人/气铲攻击机器人轮式配体/QC-气缸芯.SLDPRT

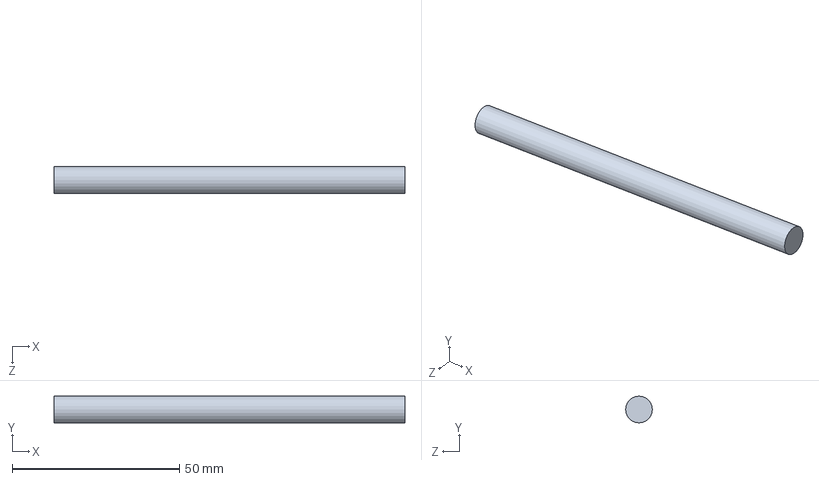
[picture p129: CAD file, 2020-02-25]
气铲攻击机器人/气铲攻击机器人轮式配体/QC-气缸芯.SLDPRT
105.0 x 8.00 x 8.00 mm
