SASU-Robotac/Robotac_Share/电铲攻击机器人/电铲攻击机器人轮式装配体/DC-轴承座板x2.SLDPRT

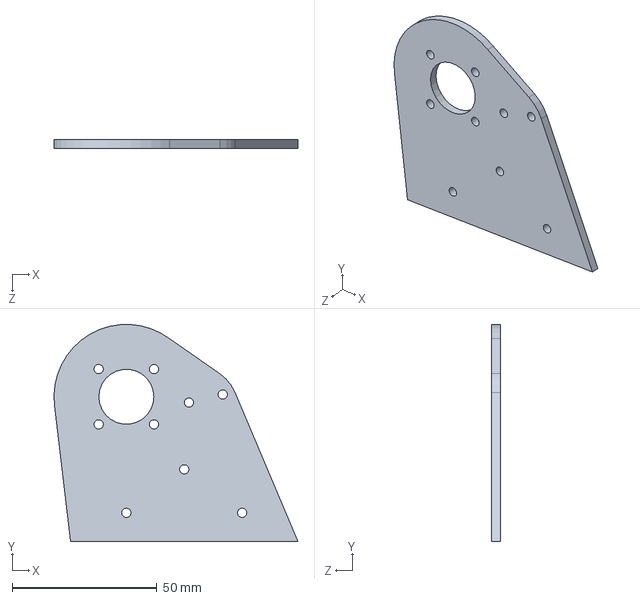
[picture p130: CAD file, 2020-02-17]
电铲攻击机器人/电铲攻击机器人轮式装配体/DC-轴承座板x2.SLDPRT
84.3 x 75.0 x 3.00 mm
