SASU-Robotac/Robotac_Share/自动机器人/自动机器人装配体/压片联轴器.SLDPRT

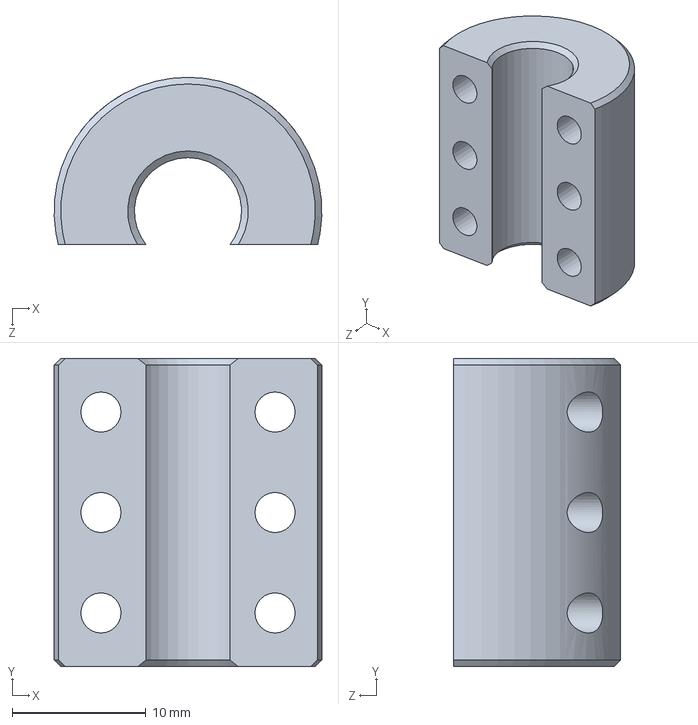
[picture p131: CAD file, 2020-03-14]
自动机器人/自动机器人装配体/压片联轴器.SLDPRT
20.0 x 23.0 x 12.5 mm
