SASU-Robotac/Robotac_Share/气铲攻击机器人/气铲攻击机器人轮式配体/QC-侧板.SLDPRT

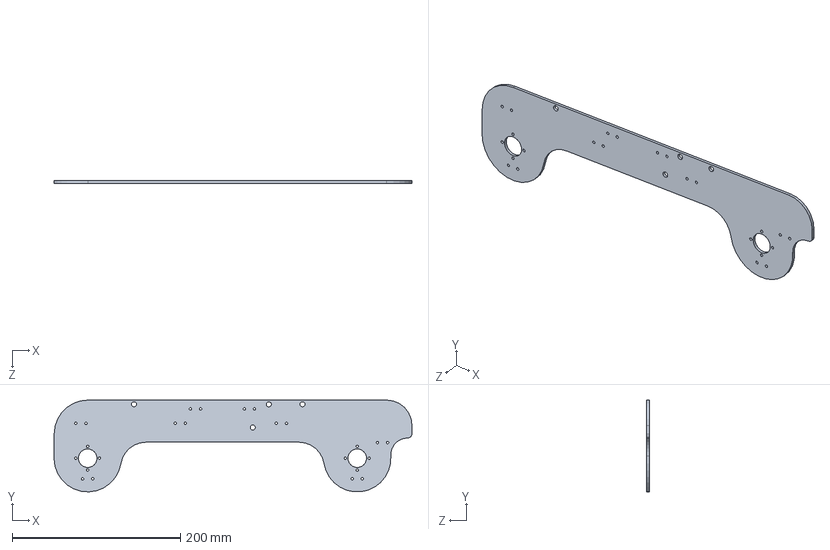
[picture p132: CAD file, 2020-02-25]
气铲攻击机器人/气铲攻击机器人轮式配体/QC-侧板.SLDPRT
425.0 x 109.0 x 3.00 mm
