SASU-Robotac/Robotac_Share/电铲攻击机器人/电铲攻击机器人轮式装配体/铲子.SLDPRT

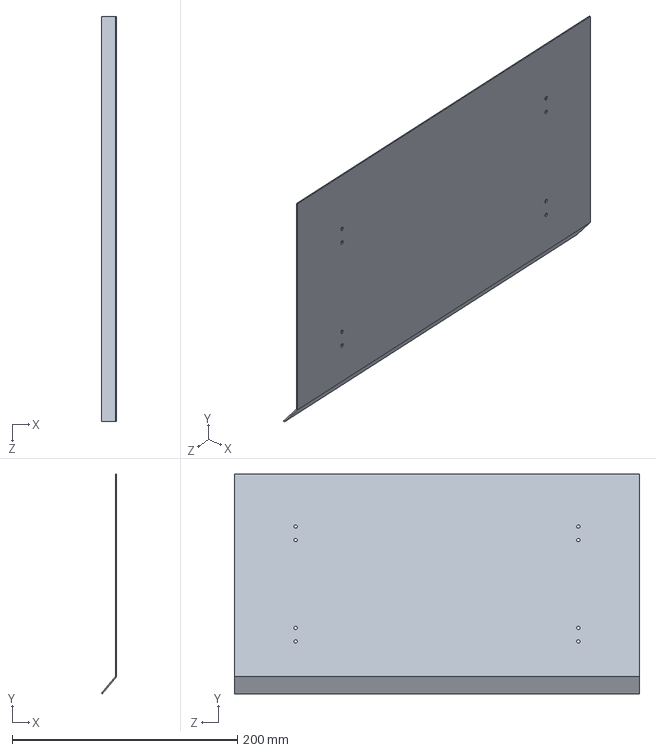
[picture p133: CAD file, 2020-02-17]
电铲攻击机器人/电铲攻击机器人轮式装配体/铲子.SLDPRT
13.6 x 195.3 x 360.0 mm
