SASU-Robotac/Robotac_Share/气铲攻击机器人/气铲攻击机器人轮式配体/铲.SLDPRT

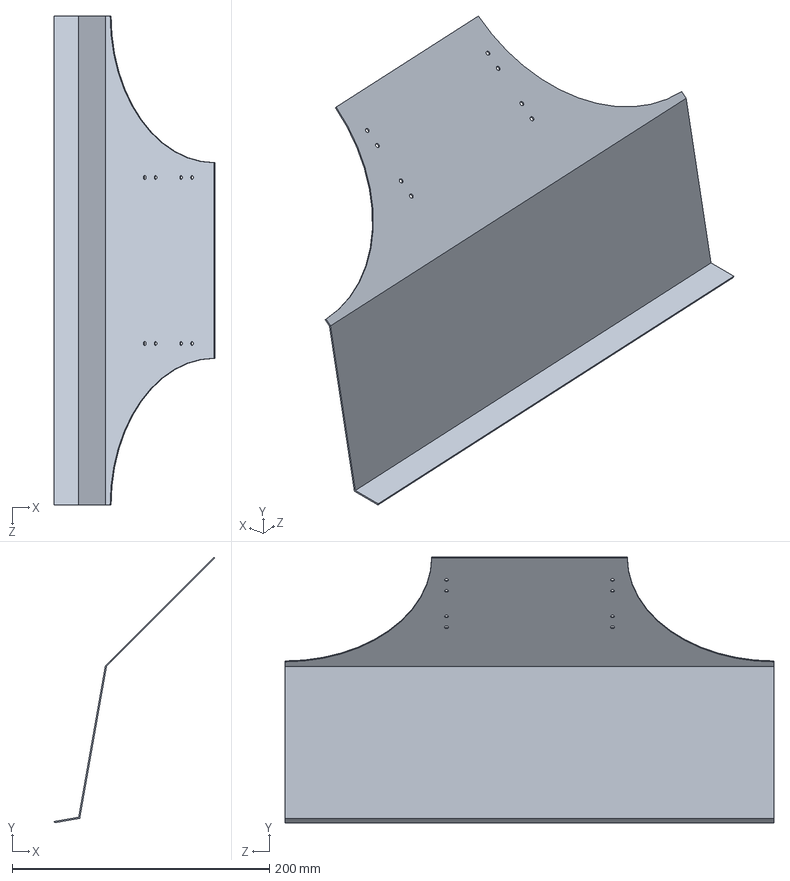
[picture p134: CAD file, 2020-02-25]
气铲攻击机器人/气铲攻击机器人轮式配体/铲.SLDPRT
124.8 x 206.4 x 380.0 mm
