SASU-Robotac/Robotac_Share/电铲攻击机器人/电铲攻击机器人轮式装配体/底板.SLDPRT

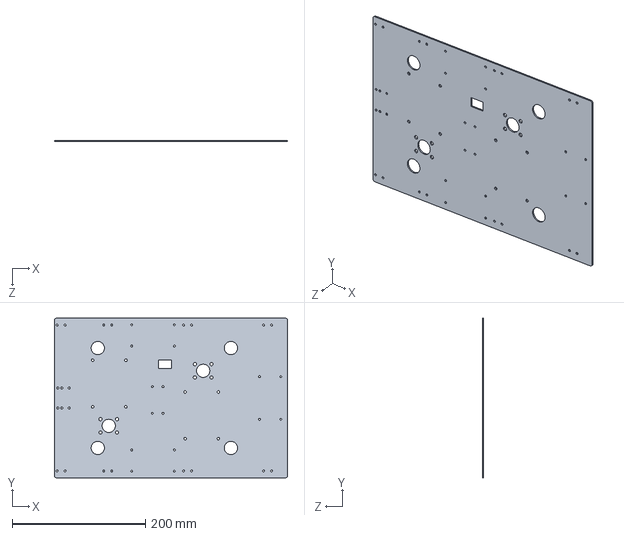
[picture p135: CAD file, 2020-02-17]
电铲攻击机器人/电铲攻击机器人轮式装配体/底板.SLDPRT
350.0 x 240.0 x 2.00 mm
