SASU-Robotac/Robotac_Share/自动机器人/自动机器人装配体/压片.SLDPRT

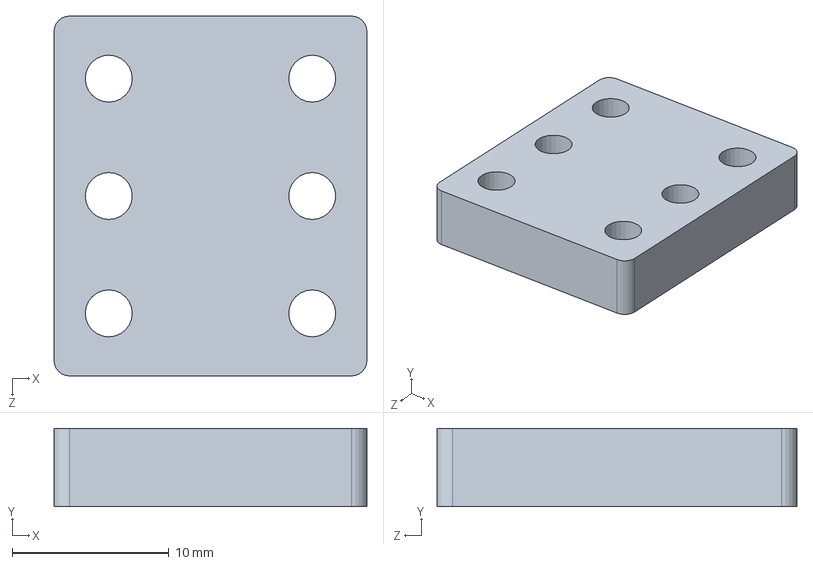
[picture p136: CAD file, 2020-03-14]
自动机器人/自动机器人装配体/压片.SLDPRT
20.0 x 5.00 x 23.0 mm
