SASU-Robotac/Robotac_Share/自动机器人/自动机器人装配体/底盘基板.SLDPRT

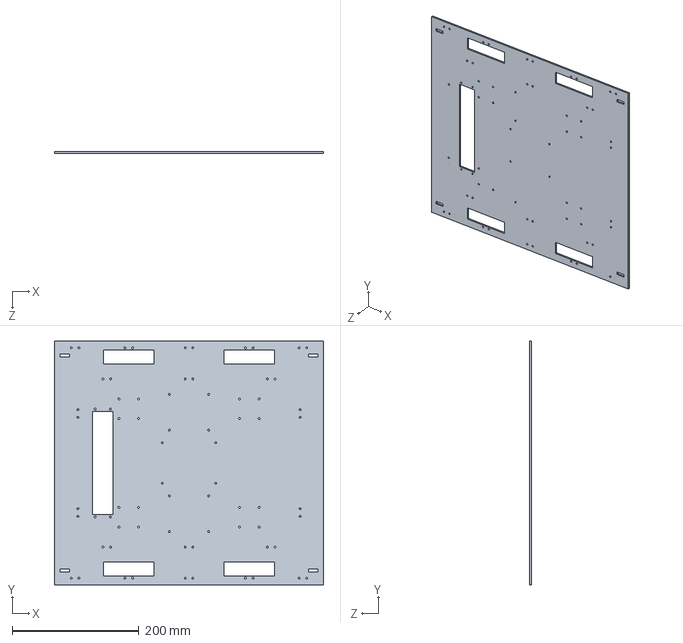
[picture p137: CAD file, 2020-03-14]
自动机器人/自动机器人装配体/底盘基板.SLDPRT
424.0 x 384.0 x 3.00 mm
