SASU-Robotac/Robotac_Share/电铲攻击机器人/电铲攻击机器人轮式装配体/DC-横轴x2.SLDPRT

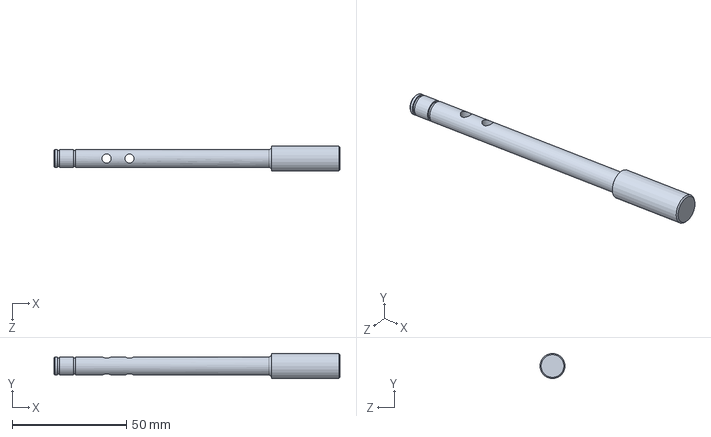
[picture p138: CAD file, 2020-02-17]
电铲攻击机器人/电铲攻击机器人轮式装配体/DC-横轴x2.SLDPRT
125.0 x 11.0 x 11.0 mm
