SASU-Robotac/Robotac_Share/气铲攻击机器人/气铲攻击机器人轮式配体/气铲横轴.SLDPRT

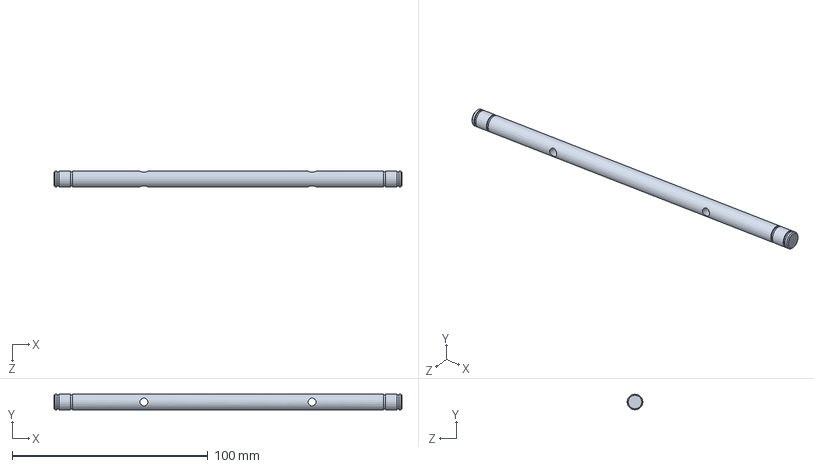
[picture p139: CAD file, 2020-02-25]
气铲攻击机器人/气铲攻击机器人轮式配体/气铲横轴.SLDPRT
178.0 x 8.00 x 8.00 mm
