SASU-Robotac/Robotac_Share/电铲攻击机器人/电铲攻击机器人轮式装配体/轴承挡片.SLDPRT

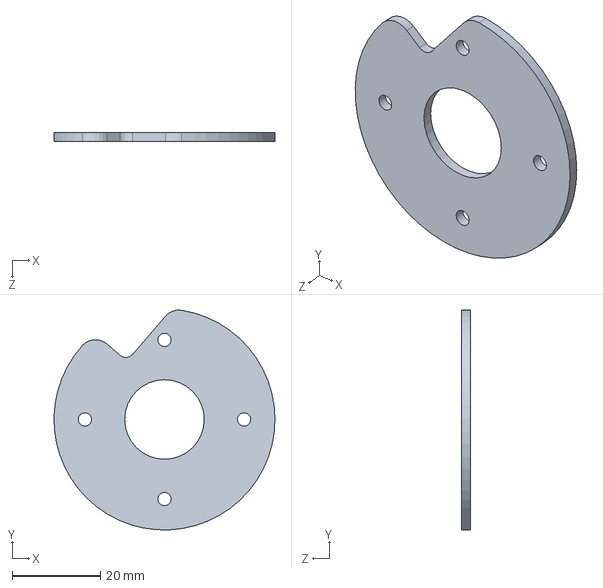
[picture p140: CAD file, 2020-02-17]
电铲攻击机器人/电铲攻击机器人轮式装配体/轴承挡片.SLDPRT
50.0 x 49.7 x 2.00 mm
