SASU-Robotac/Robotac_Share/自动机器人/自动机器人装配体/盖板.SLDPRT

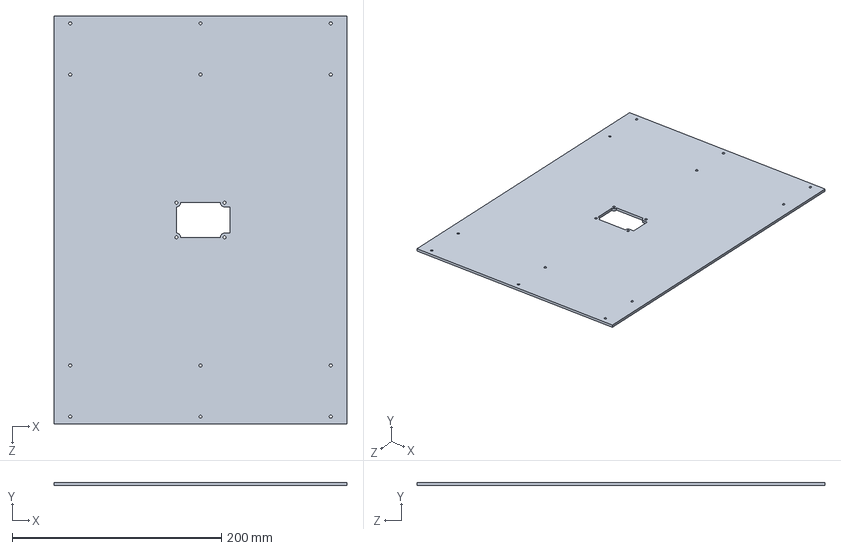
[picture p141: CAD file, 2020-03-14]
自动机器人/自动机器人装配体/盖板.SLDPRT
280.0 x 3.00 x 390.0 mm
