SASU-Robotac/Robotac_Share/气铲攻击机器人/气铲攻击机器人轮式配体/QC-轴支撑板.SLDPRT

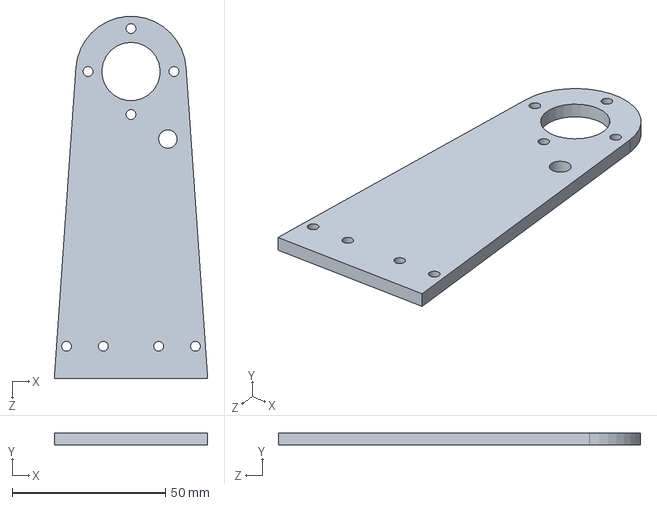
[picture p142: CAD file, 2020-02-25]
气铲攻击机器人/气铲攻击机器人轮式配体/QC-轴支撑板.SLDPRT
50.0 x 4.00 x 117.9 mm
