SASU-Robotac/Robotac_Share/电铲攻击机器人/电铲攻击机器人轮式装配体/DC-换向器座.SLDPRT

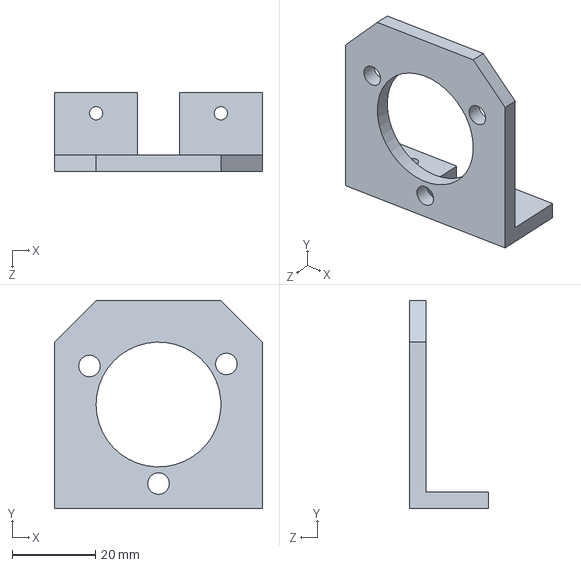
[picture p143: CAD file, 2020-02-17]
电铲攻击机器人/电铲攻击机器人轮式装配体/DC-换向器座.SLDPRT
50.0 x 50.0 x 19.0 mm
