SASU-Robotac/Robotac_Share/电铲攻击机器人/电铲攻击机器人轮式装配体/DC-换向器.SLDPRT

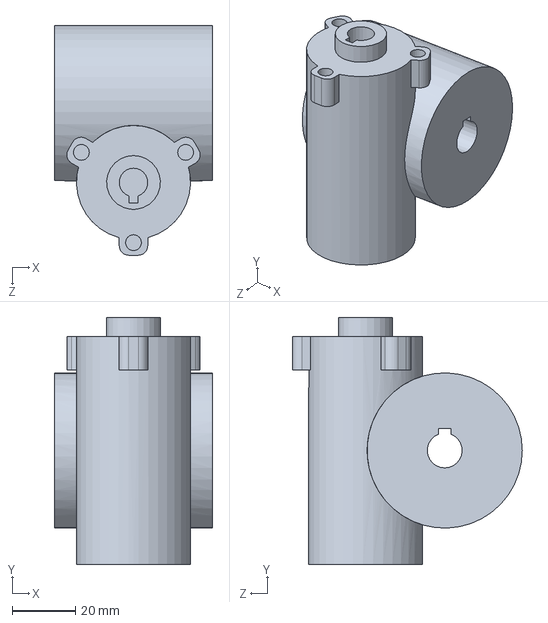
[picture p144: CAD file, 2020-02-17]
电铲攻击机器人/电铲攻击机器人轮式装配体/DC-换向器.SLDPRT
50.0 x 78.0 x 72.5 mm
