SASU-Robotac/Robotac_Share/气铲攻击机器人/气铲攻击机器人轮式配体/地面.SLDPRT

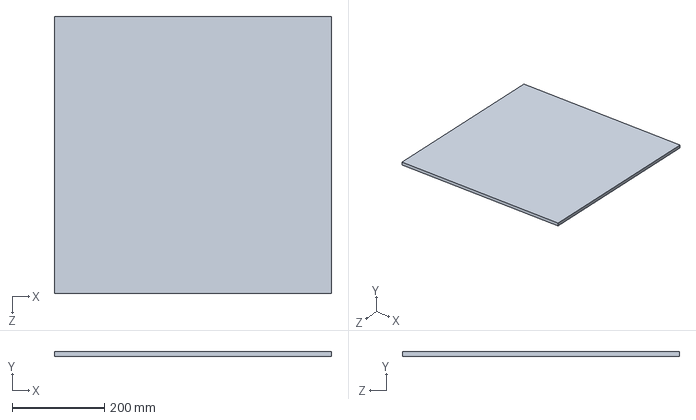
[picture p145: CAD file, 2020-02-17]
气铲攻击机器人/气铲攻击机器人轮式配体/地面.SLDPRT
600.0 x 10.0 x 600.0 mm
