SASU-Robotac/Robotac_Share/气铲攻击机器人/气铲攻击机器人轮式配体/法兰联轴器-孔8.SLDPRT

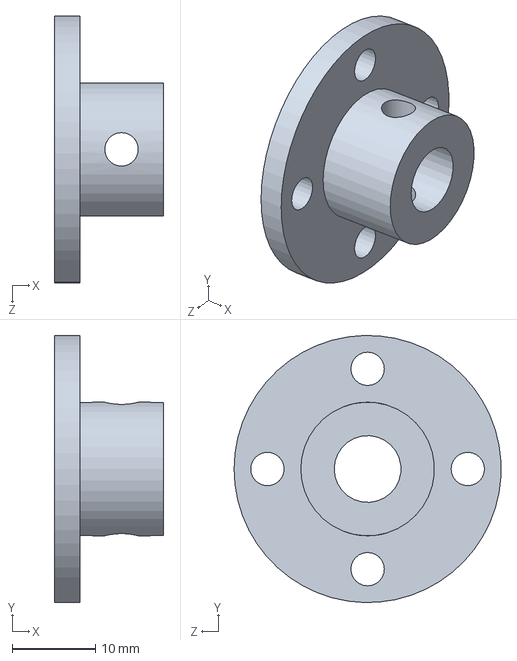
[picture p146: CAD file, 2020-02-17]
气铲攻击机器人/气铲攻击机器人轮式配体/法兰联轴器-孔8.SLDPRT
13.0 x 32.0 x 32.0 mm
