SASU-Robotac/Robotac_Share/气铲攻击机器人/气铲攻击机器人轮式配体/辅助轮.SLDPRT

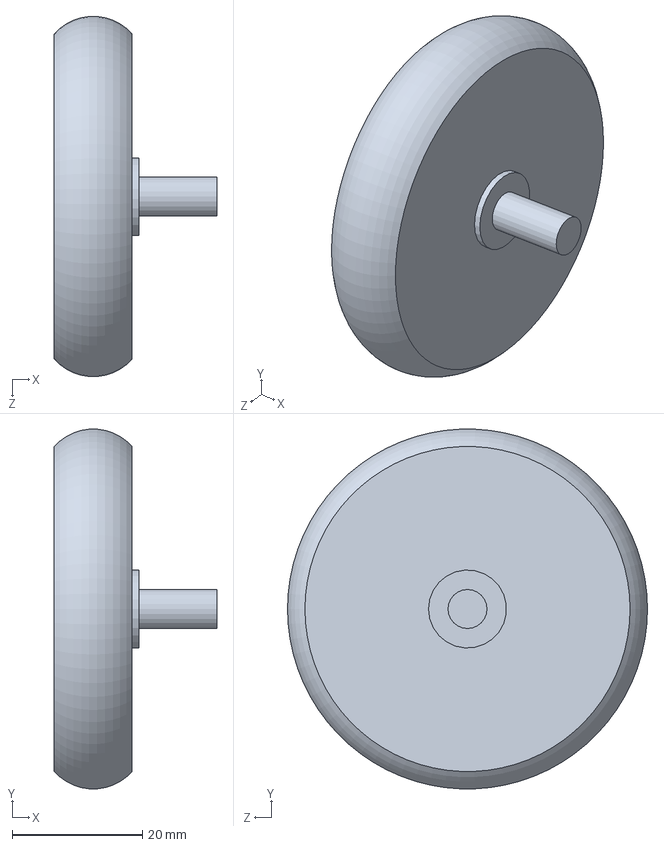
[picture p147: CAD file, 2020-02-17]
气铲攻击机器人/气铲攻击机器人轮式配体/辅助轮.SLDPRT
25.0 x 55.3 x 55.4 mm
