SASU-Robotac/Robotac_Share/气铲攻击机器人/气铲攻击机器人轮式配体/轮毂.SLDPRT

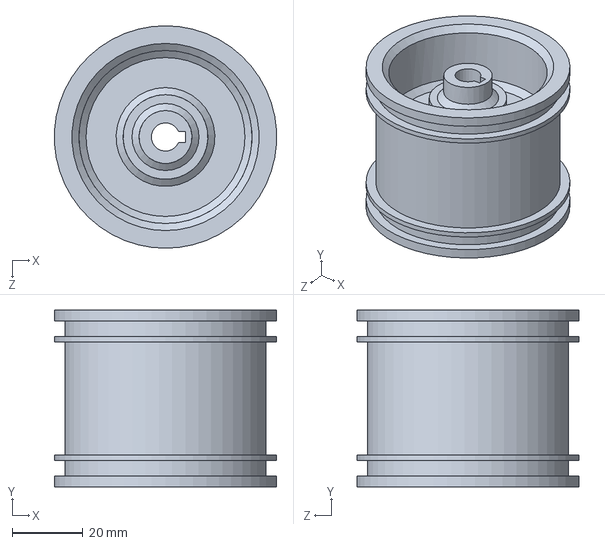
[picture p148: CAD file, 2020-01-18]
气铲攻击机器人/气铲攻击机器人轮式配体/轮毂.SLDPRT
62.9 x 50.0 x 63.0 mm
