SASU-Robotac/Robotac_Share/气铲攻击机器人/气铲攻击机器人轮式配体/六角联轴器.SLDPRT

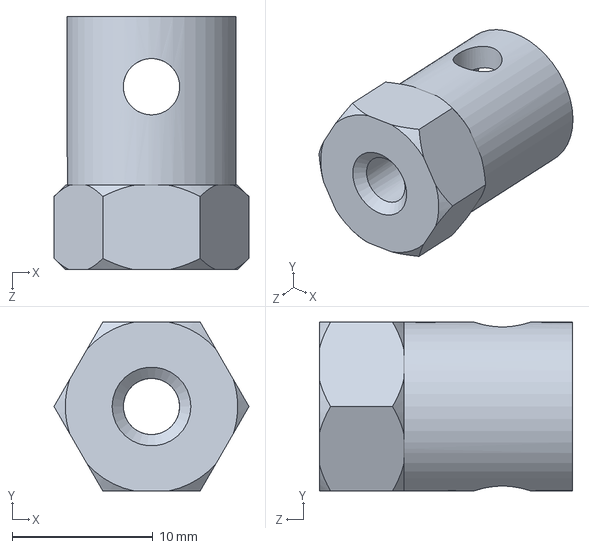
[picture p149: CAD file, 2020-01-18]
气铲攻击机器人/气铲攻击机器人轮式配体/六角联轴器.SLDPRT
13.9 x 12.0 x 18.0 mm
