SASU-Robotac/Robotac_Share/气铲攻击机器人/气铲攻击机器人轮式配体/胎皮.SLDPRT

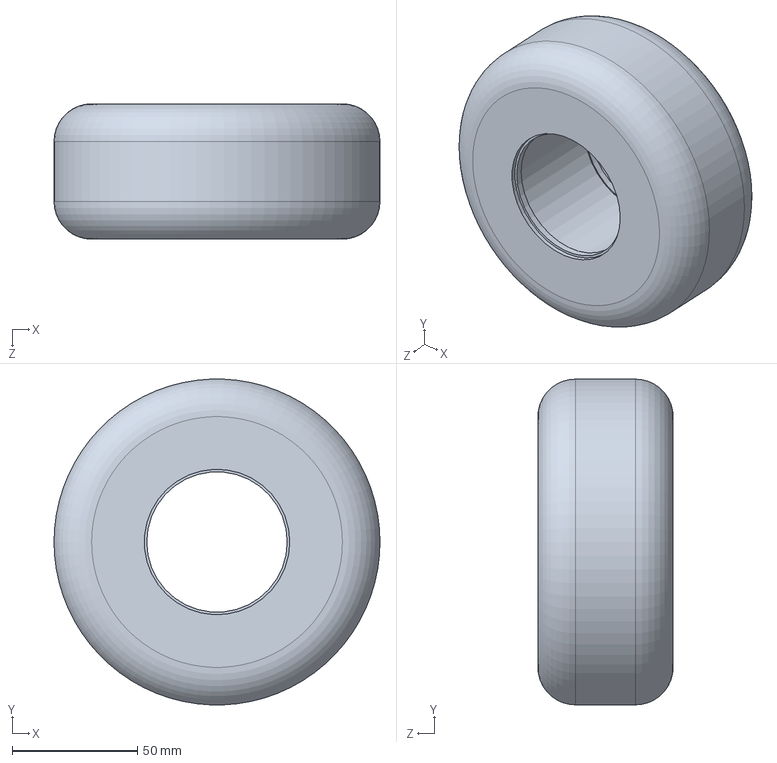
[picture p150: CAD file, 2020-01-18]
气铲攻击机器人/气铲攻击机器人轮式配体/胎皮.SLDPRT
130.0 x 129.9 x 54.0 mm
