SASU-Robotac/Robotac_Share/气铲攻击机器人/气铲攻击机器人轮式配体/轮毂片.SLDPRT

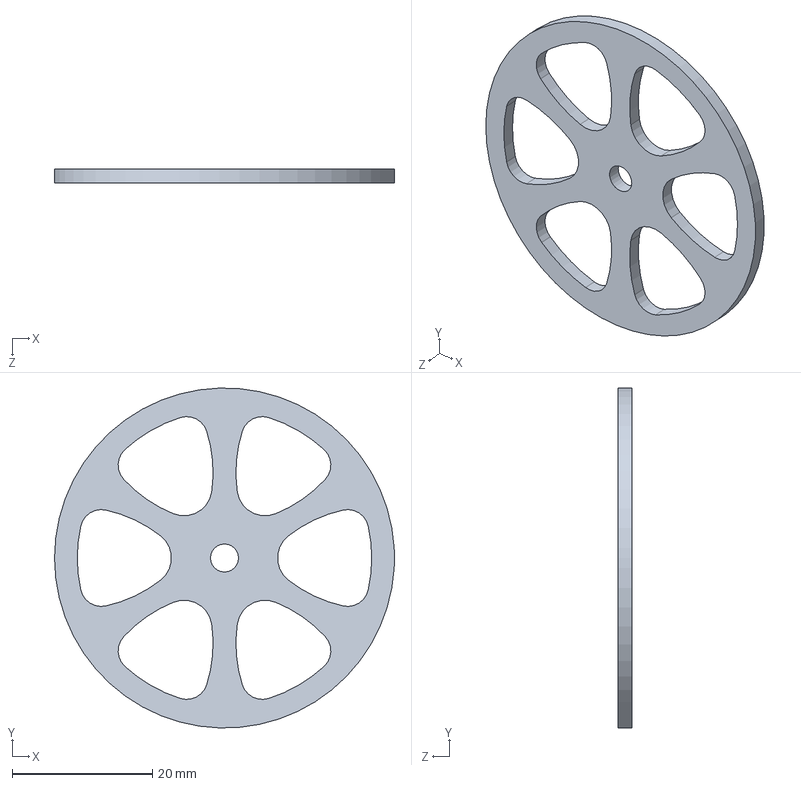
[picture p151: CAD file, 2020-01-18]
气铲攻击机器人/气铲攻击机器人轮式配体/轮毂片.SLDPRT
48.5 x 48.5 x 2.00 mm
