SASU-Robotac/Robotac_Share/(list of files, cad)

Other CAD files:
气铲攻击机器人/气铲攻击机器人轮式配体/轮系.SLDASM
电铲攻击机器人/电铲攻击机器人轮式装配体/DC-轴承.SLDPRT
气铲攻击机器人/气铲攻击机器人轮式配体/直角连接件.SLDPRT
电铲攻击机器人/电铲攻击机器人轮式装配体/电机座.SLDPRT
自动机器人/自动机器人装配体/电机座.SLDPRT
电铲攻击机器人/电铲攻击机器人轮式装配体/TY-直角连接件.SLDPRT
气铲攻击机器人/气铲攻击机器人轮式配体/镜向QC-轴支撑板.SLDPRT
电铲攻击机器人/电铲攻击机器人轮式装配体/直角连接件.SLDPRT
气铲攻击机器人/气铲攻击机器人轮式配体/镜向法兰联轴器-孔8.SLDPRT
气铲攻击机器人/气铲攻击机器人轮式配体/电机YG36-555.SLDPRT
气铲攻击机器人/气铲攻击机器人轮式配体/M8x120螺栓.SLDPRT
气铲攻击机器人/气铲攻击机器人轮式配体/M8x35螺栓.SLDPRT
