SASU-Robotac/Robotac_Share/(commit log)

2020-01-18 添加基础底盘制作文档及机械图
    [六角联轴器.SLDPRT, 基础车.SLDASM, 基础车钣金.SLDPRT, 电机YG36-555.SLDPRT, 电机座.SLDPRT, 胎皮.SLDPRT, 轮毂.SLDPRT, 轮毂片.SLDPRT]
2020-02-17 开源电铲攻击机器人相关文档及装配体
    [DC-RE40.SLDPRT, DC-换向器.SLDPRT, DC-换向器座.SLDPRT, DC-机构.SLDASM, DC-横轴x2.SLDPRT, DC-法兰盘x2.SLDPRT, DC-电机座.SLDPRT, DC-纵轴.SLDPRT]
2020-02-25 开源气铲攻击机器人相关文档及装配体
    [6mm轴承.SLDPRT, M8x120螺栓.SLDPRT, M8x35螺栓.SLDPRT, QC-下板.SLDPRT, QC-侧板.SLDPRT, QC-底板.SLDPRT, QC-杆端轴承.SLDPRT, QC-气缸.SLDASM]
2020-03-14 开源自动机器人相关文档及装配体
    [4红外测距.SLDPRT, 侧面基板.SLDPRT, 内侧轴承板.SLDPRT, 压片.SLDPRT, 压片联轴器.SLDPRT, 底盘基板.SLDPRT, 底盘装配体.SLDASM, 电机YG36-555.SLDPRT]
2020-03-28 开源自动机器人基础程序及相关文档
